berta00/precharge-controller/README.md

# Hardware precharge-controller
Hardware-only precharge controller design for the E-Agle Trento Racing Team electronics recruitment test.
[Project task](https://github.com/eagletrt/recruitment-hw/tree/master/task-3)

## Project structure
- `./docs`:
  - `datasheet`: Datasheets of all the used components
  - `img`: Images used in markdown files
  - `BOM.csv`: Bill Of Material file
  - `DESCRIPTION.md`: Description file containing a complete overview about the project
  - `SIZING.md`: Sizing file containing all the calculations and considerations
  - `precharge-controller.pdf`: Final project sheets export
- `./hardware`:
  - `libs`: Libraries used in kicad project
  - `sim`: LTspice simulation files
  - `kicad files`

## Project description
For for a project description, refer to the [Project Description](docs/DESCRIPTION.md) \
For the sizing calculations, refer to the [Project Sizings](docs/SIZING.md)
