berta00/precharge-controller/docs/img/lv_logic_2_sheet.png

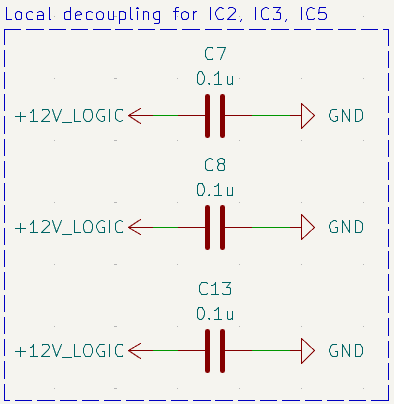
docs/img/lv_logic_2_sheet.png
