berta00/precharge-controller/docs/img/TC4S584F_VP_PLOT.png

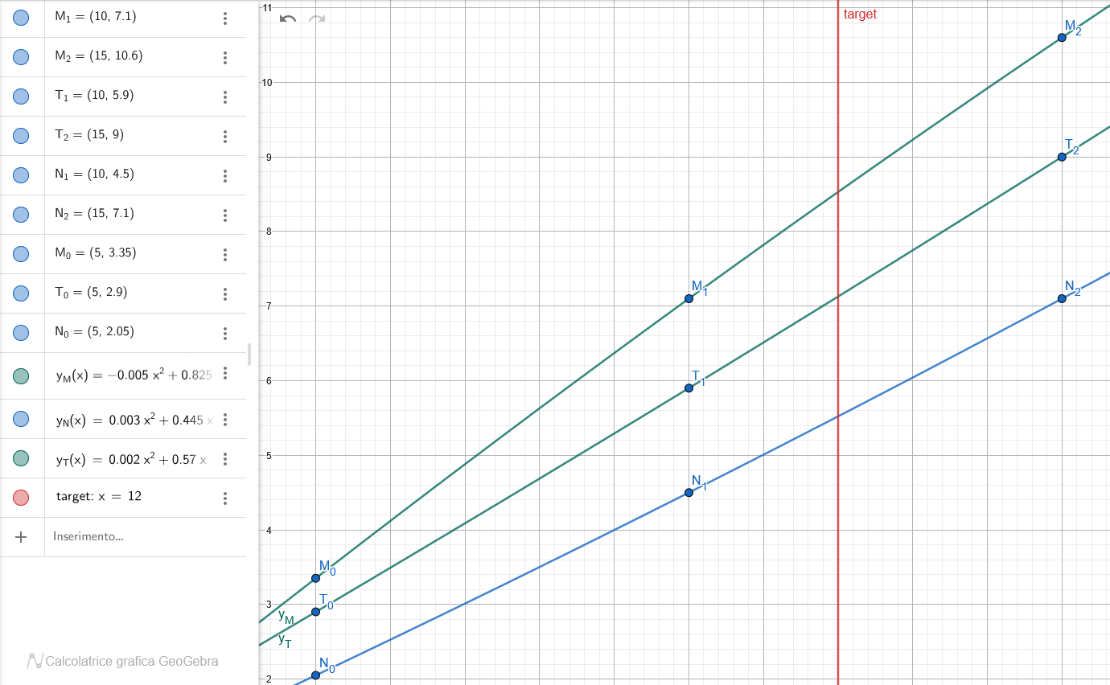
docs/img/TC4S584F_VP_PLOT.png
