berta00/precharge-controller/docs/BOM.csv

Reference | Qty | Value | Manufacturer_Part_Number | Mouser Part Number | MANUFACTURER | Datasheet
C1 | 1 | 0.33uF | C0805C334J5RACAUTO | 80-C0805C334J5RAUTO | KEMET | link
C2,C3,C7,C8,C10,C11,C12,C13 | 8 | 0.1uF | C0805X104K5RACAUTO | 80-C0805X104K5RAUTO | KEMET | link
C4 | 1 | 270uF | 35CZH270M10X9 | 232-35CZH270M10X9 | Rubycon | link
C5,C6,C9 | 3 | 1uF | C0805X105J5RACAUTO | 80-C0805X105J5RAUTO | KEMET | link
C14,C15,C16 | 3 | 3600uF | PHH223HKP4360ME4 | 80-PHH223HKP4360ME4 | KEMET | link
D1,D3 | 2 | 15V | MMSZ5245BHE3-TP | 833-MMSZ5245BHE3-TP | Micro Commercial Components (MCC) | link
D2,D13 | 2 | 28V | MMSZ5255BQ-7-F | 621-MMSZ5255BQ-7-F | Diodes Incorporated | link
D5,D12 | 2 | 12V | BZT52C12-HE3-08 | 78-BZT52C12-HE3-08 | Vishay Semiconductors | link
D6,D8,D10 | 3 | 400V | S1G | 603-S1G | YAGEO | link
D7,D9,D11 | 3 | 36V | 1SMA5938BT3G | 863-1SMA5938BT3G | onsemi | link
IC1 | 1 | L7812ABV | L7812ABV | 511-L7812ABV | STMicroelectronics | link
IC2 | 1 | CD4081BM96 | CD4081BM96 | 595-CD4081BM96 | Texas Instruments | link
IC3 | 1 | CD40106BM96 | CD40106BM96 | 595-CD40106BM96 | Texas Instruments | link
IC4 | 1 | LM393BIDR | LM393BIDR | 595-LM393BIDR | Texas Instruments | link
IC5 | 1 | CD4071BM96 | CD4071BM96 | 595-CD4071BM96 | Texas Instruments | link
J1 | 1 | DTF13-4P-G003 | DTF13-4P-G003 | 571-DTF13-4P-G003 | TE Connectivity / DEUTSCH | link
J2,J3,J4 | 3 | 9500630000 | 9500630000 | 470-9500630000 | Weidmuller | link
PS1 | 1 | DEP1-12-S12-M | DEP1-12-S12-M | 490-DEP1-12-S12-M | CUI Inc. | link
Q1,Q2 | 2 | SI3437DV-T1-GE3 | SI3437DV-T1-GE3 | 781-SI3437DV-GE3 | Vishay Semiconductors | link
Q3,Q5,Q6 | 3 | DMN6140LQ-7 | DMN6140LQ-7 | 621-DMN6140LQ-7 | Diodes Incorporated | link
Q4 | 1 | 2N7002K | 2N7002K | 512-2N7002K | onsemi | link
Q7 | 1 | APC-817D1-SL | APC-817D1-SL | 442-APC817D1SL | American Bright LED | link
R1,R2,R8,R10,R11,R12,R13,R24 | 8 | 10k | AT0805FRD0710KL | 603-AT0805FRD0710KL | YAGEO | link
R3,R4,R5,R20,R21,R22 | 6 | 330k | TNPV1206330KBEEA | 71-TNPV1206330KBEEA | Vishay / Dale | link
R6 | 1 | 56k | ERA-6ARB563V | 667-ERA-6ARB563V | Panasonic Industry | link
R7 | 1 | 20k | ERA-8APB203V | 667-ERA-8APB203V | Panasonic Industry | link
R9 | 1 | 4.7k | AA0805FR-074K7L | 603-AA0805FR-074K7L | YAGEO | link
R14,R15,R16,R18 | 4 | 1k | RC0805FR-071KL | 603-RC0805FR-071KL | YAGEO | link
R19 | 1 | 100 | AA0805FR-13100RL | 603-AA0805FR-13100RL | YAGEO | link
R23 | 1 | 21k | ERA-8AEB2102V | 667-ERA-8AEB2102V | Panasonic Industry | link
R25,R26,R27 | 3 | 51 | RSF2WSJR-52-51R | 603-RSF2WSJR-52-51R | YAGEO | link
R28,R29 | 2 | 10 | SR0805FR-7W10RL | 603-SR0805FR-7W10RL | YAGEO | link
U2,U3,U4 | 3 | G9KB-1A DC12 | G9KB-1ADC12 | 653-G9KB-1ADC12 | Aratas | link
Precharge resistor | 1 | / | HSA501K0J | 279-HSA501K0J | TE Connectivity / Holsworthy | link
Male lv connector | 1 | / | DT06-4S | 571-DT06-4S | TE Connectivity / DEUTSCH | link
Wedge lv connector | 1 | / | W4S-ZZ | 571-W4S-ZZ | TE Connectivity / DEUTSCH | link
Internal pins lv connector | 4 | / | 0462-201-1631 | 571-0462-201-1631 | TE Connectivity / DEUTSCH | link
