berta00/precharge-controller/docs/precharge-controller.pdf

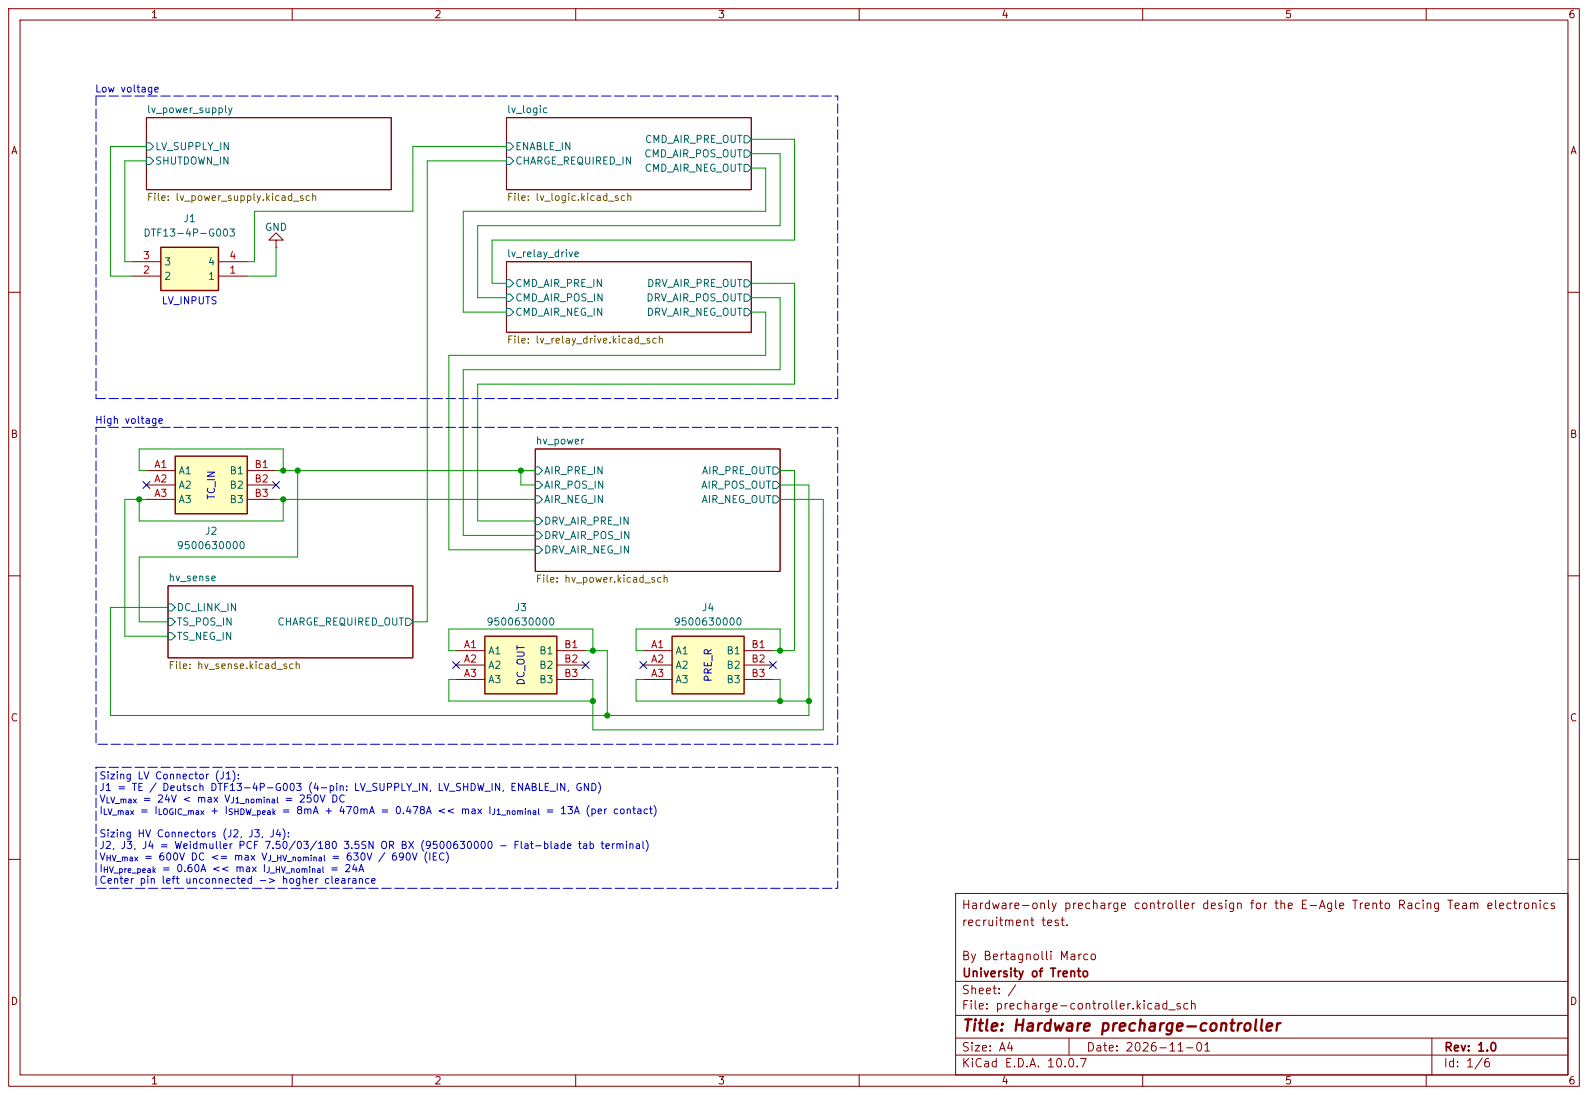
[picture p20: page 1]

Sizing LV Connector (J1): J1 = TE / Deutsch DTF13-4P-G003 (4-pin: LV_SUPPLY_IN, LV_SHDW_IN, ENABLE_IN, GND) VLV_max = 24V < max VJ1_nominal = 250V DC

Sizing HV Connectors (J2, J3, J4):
J2, J3, J4 = Weidmuller PCF 7.50/03/180 3.5SN OR BX (9500630000 - Flat-blade tab terminal) VHV_max = 600V DC <= max VJ_HV_nominal = 630V / 690V (IEC)

IHV_pre_peak = 0.60A << max IJ_HV_nominal = 24A Center pin left unconnected -> hogher clearance

Hardware-only precharge controller design for the E-Agle Trento Racing Team electronics
recruitment test.

By Bertagnolli Marco
University of Trento
Sheet: /
File: precharge-controller.kicad_sch
Title: Hardware precharge-controller

Size: A4 | Rev: 1.0
KiCad E.D.A. 10.0.7 | Id: 1/6

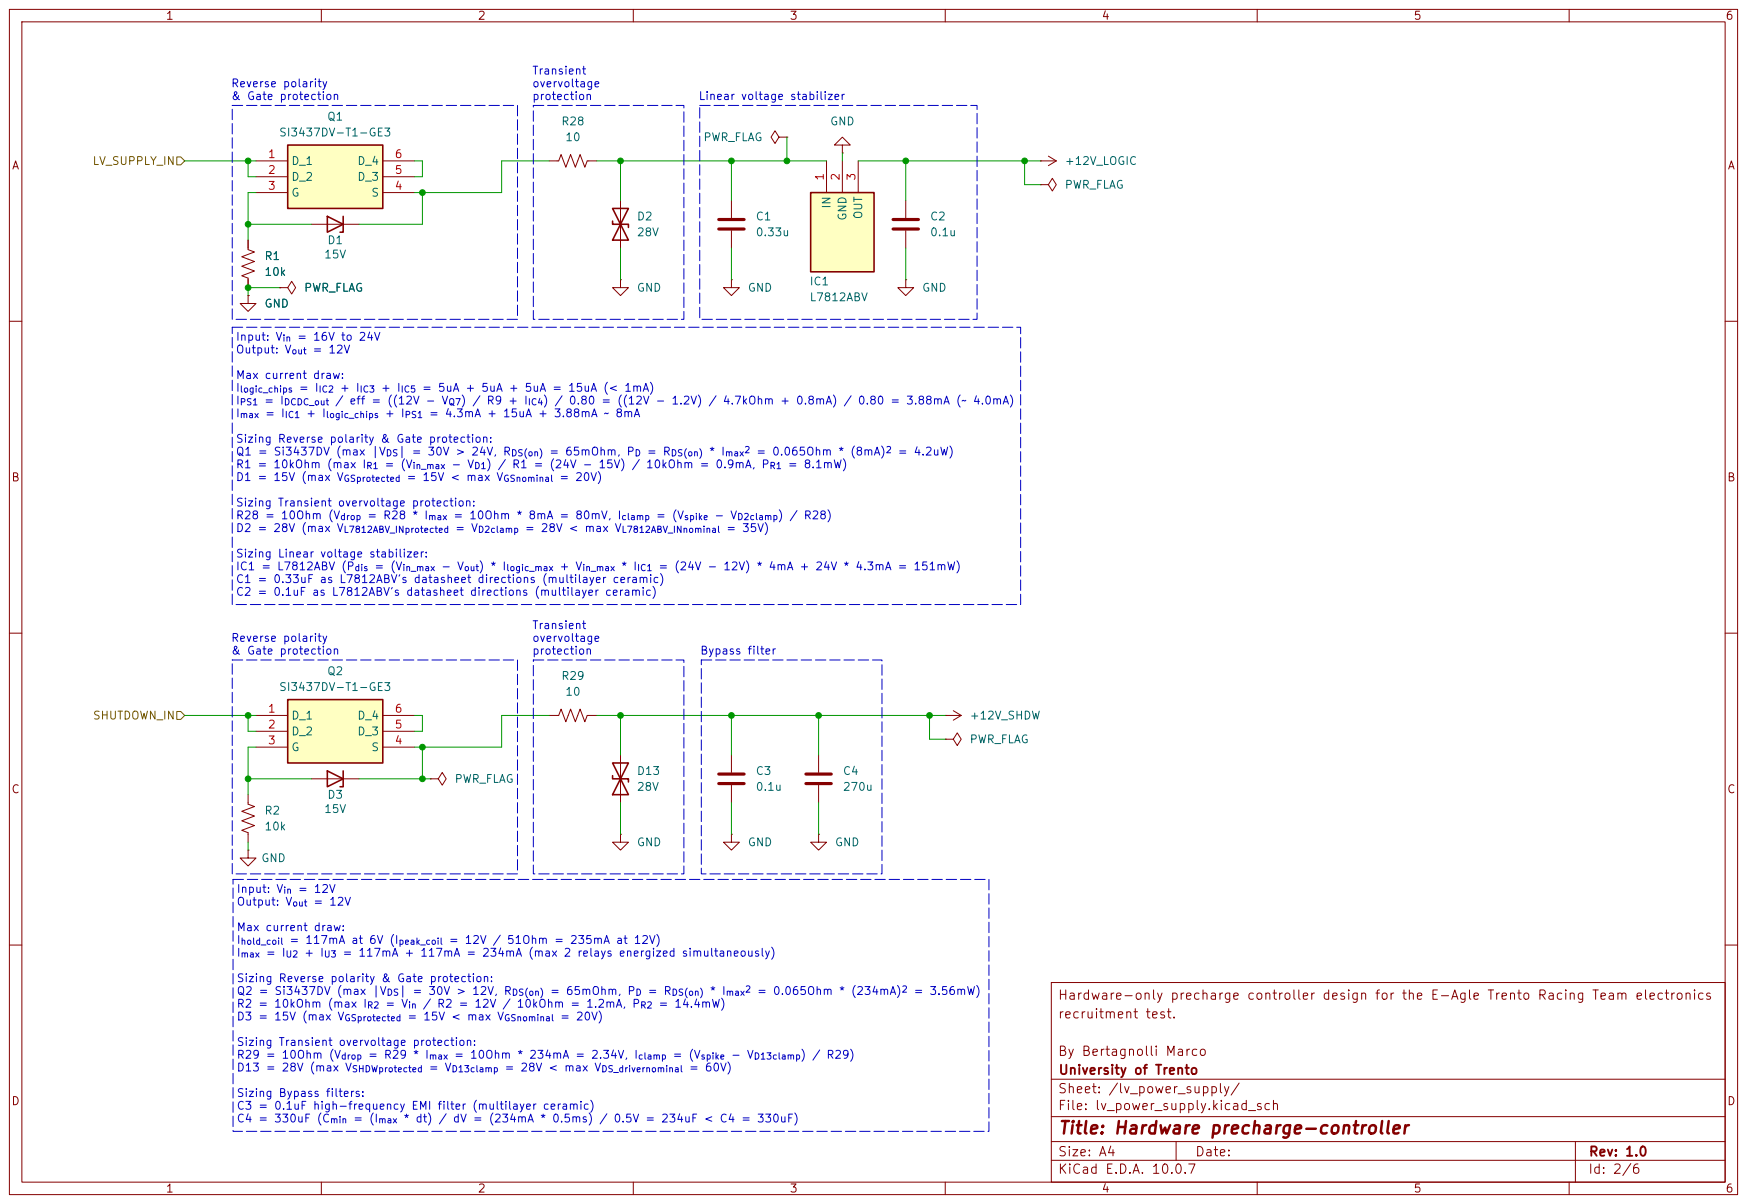
[picture p21: page 2]

Input: Vin = 16V to 24V Output: Vout = 12V Max current draw:

Ilogic_chips = IIC2 + IIC3 + IIC5 = 5uA + 5uA + 5uA = 15uA (< 1mA)
IPS1 = IDCDC_out / eff = ((12V - VQ7) / R9 + IIC4) / 0.80 = ((12V - 1.2V) / 4.7kOhm + 0.8mA) / 0.80 = 3.88mA (~ 4.0mA)
Imax = IIC1 + Ilogic_chips + IPS1 = 4.3mA + 15uA + 3.88mA ~ 8mA Sizing Reverse polarity & Gate protection: Q1 = Si3437DV (max |VDS| = 30V > 24V, RDS(on) = 65mOhm, PD = RDS(on) * Imax2 = 0.065Ohm * (8mA)2 = 4.2uW) R1 = 10kOhm (max IR1 = (Vin_max - VD1) / R1 = (24V - 15V) / 10kOhm = 0.9mA, PR1 = 8.1mW) D1 = 15V (max VGSprotected = 15V < max VGSnominal = 20V)

Sizing Transient overvoltage protection: R28 = 10Ohm (Vdrop = R28 * Imax = 10Ohm * 8mA = 80mV, Iclamp = (Vspike - VD2clamp) / R28) D2 = 28V (max VL7812ABV_INprotected = VD2clamp = 28V < max VL7812ABV_INnominal = 35V)

Sizing Linear voltage stabilizer:
IC1 = L7812ABV (Pdis = (Vin_max - Vout) * Ilogic_max + Vin_max * IIC1 = (24V - 12V) * 4mA + 24V * 4.3mA = 151mW) C1 = 0.33uF as L7812ABV's datasheet directions (multilayer ceramic) C2 = 0.1uF as L7812ABV's datasheet directions (multilayer ceramic)

Bypass filter Reverse polarity & Gate protection

Input: Vin = 12V Output: Vout = 12V Max current draw:

Ihold_coil = 117mA at 6V (Ipeak_coil = 12V / 51Ohm = 235mA at 12V)
Imax = IU2 + IU3 = 117mA + 117mA = 234mA (max 2 relays energized simultaneously)

Sizing Reverse polarity & Gate protection: Q2 = Si3437DV (max |VDS| = 30V > 12V, RDS(on) = 65mOhm, PD = RDS(on) * Imax2 = 0.065Ohm * (234mA)2 = 3.56mW) R2 = 10kOhm (max IR2 = Vin / R2 = 12V / 10kOhm = 1.2mA, PR2 = 14.4mW) D3 = 15V (max VGSprotected = 15V < max VGSnominal = 20V)

Hardware-only precharge controller design for the E-Agle Trento Racing Team electronics
recruitment test.

Sizing Transient overvoltage protection: R29 = 10Ohm (Vdrop = R29 * Imax = 10Ohm * 234mA = 2.34V, Iclamp = (Vspike - VD13clamp) / R29) D13 = 28V (max VSHDWprotected = VD13clamp = 28V < max VDS_drivernominal = 60V)

By Bertagnolli Marco
University of Trento
Sheet: /lv_power_supply/
File: lv_power_supply.kicad_sch
Title: Hardware precharge-controller

Sizing Bypass filters: C3 = 0.1uF high-frequency EMI filter (multilayer ceramic) C4 = 330uF (Cmin = (Imax * dt) / dV = (234mA * 0.5ms) / 0.5V = 234uF < C4 = 330uF)

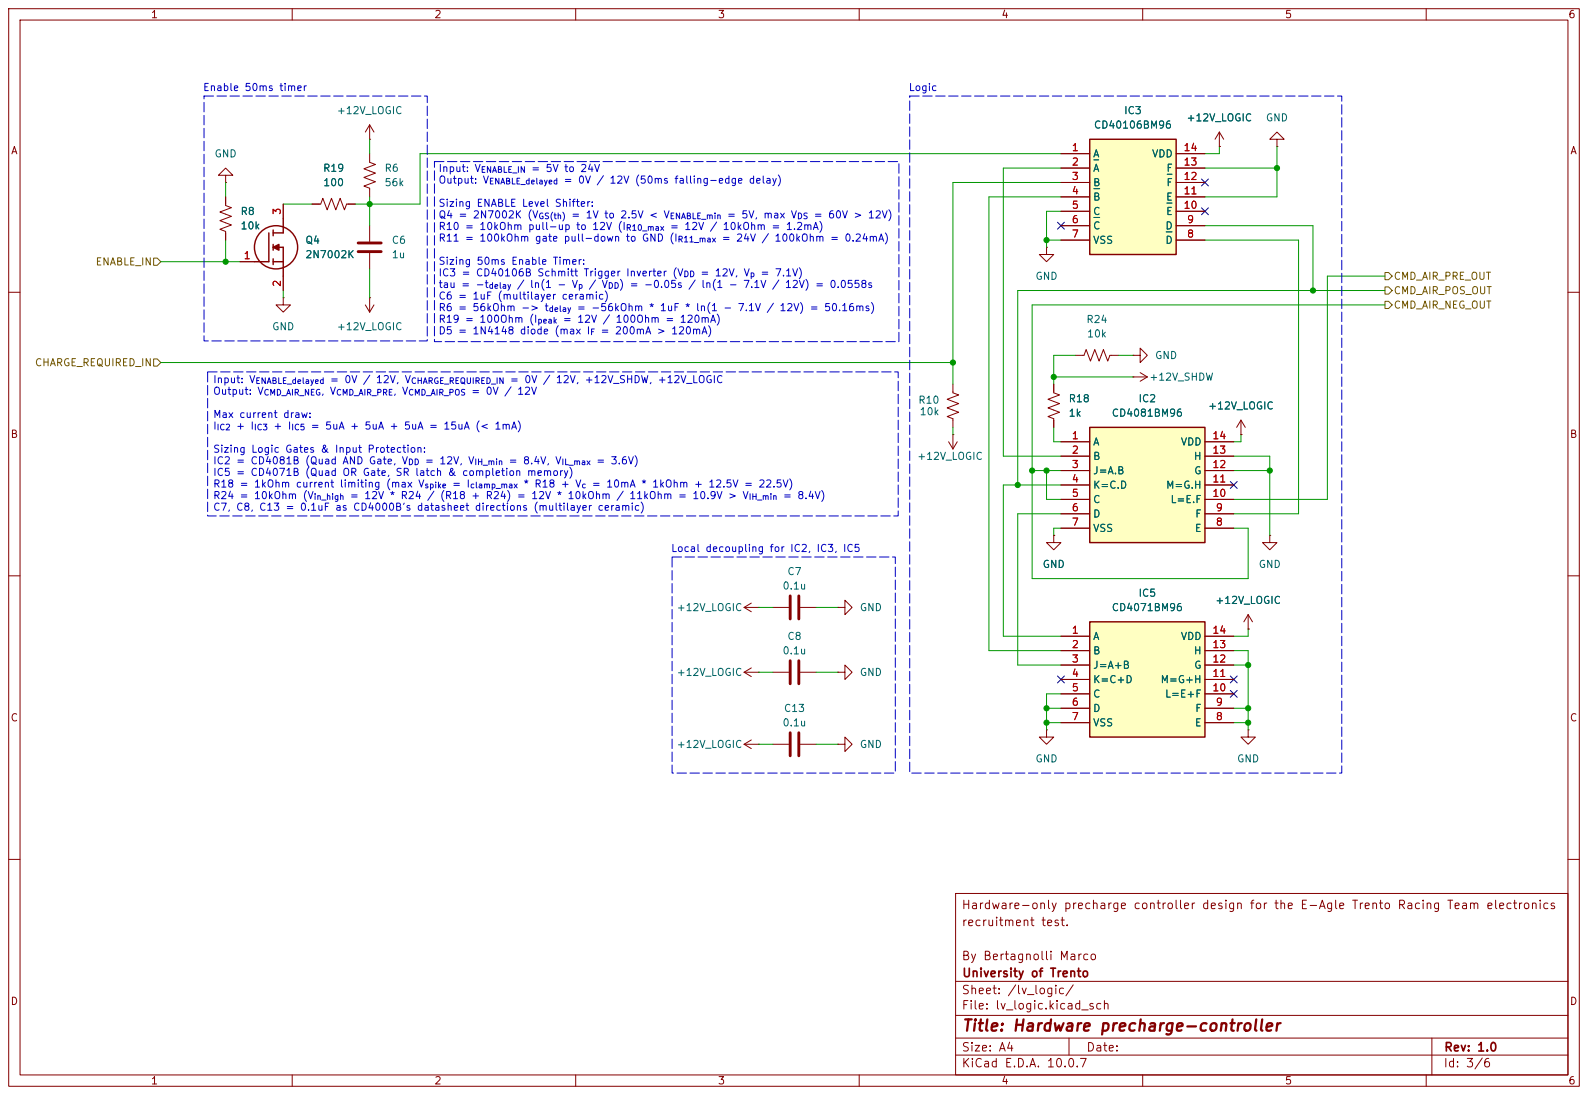
[picture p22: page 3]

Input: VENABLE_IN = 5V to 24V Output: VENABLE_delayed = 0V / 12V (50ms falling-edge delay)

Sizing ENABLE Level Shifter: Q4 = 2N7002K (VGS(th) = 1V to 2.5V < VENABLE_min = 5V, max VDS = 60V > 12V) R10 = 10kOhm pull-up to 12V (IR10_max = 12V / 10kOhm = 1.2mA) R11 = 100kOhm gate pull-down to GND (IR11_max = 24V / 100kOhm = 0.24mA)

Sizing 50ms Enable Timer:
IC3 = CD40106B Schmitt Trigger Inverter (VDD = 12V, Vp = 7.1V)
tau = -tdelay / ln(1 - Vp / VDD) = -0.05s / ln(1 - 7.1V / 12V) = 0.0558s C6 = 1uF (multilayer ceramic) R6 = 56kOhm -> tdelay = -56kOhm * 1uF * ln(1 - 7.1V / 12V) = 50.16ms) R19 = 100Ohm (Ipeak = 12V / 100Ohm = 120mA) D5 = 1N4148 diode (max IF = 200mA > 120mA)

Input: VENABLE_delayed = 0V / 12V, VCHARGE_REQUIRED_IN = 0V / 12V, +12V_SHDW, +12V_LOGIC Output: VCMD_AIR_NEG, VCMD_AIR_PRE, VCMD_AIR_POS = 0V / 12V Max current draw:

Sizing Logic Gates & Input Protection:
IC2 = CD4081B (Quad AND Gate, VDD = 12V, VIH_min = 8.4V, VIL_max = 3.6V)
IC5 = CD4071B (Quad OR Gate, SR latch & completion memory) R18 = 1kOhm current limiting (max Vspike = Iclamp_max * R18 + Vc = 10mA * 1kOhm + 12.5V = 22.5V) R24 = 10kOhm (Vin_high = 12V * R24 / (R18 + R24) = 12V * 10kOhm / 11kOhm = 10.9V > VIH_min = 8.4V)

C7, C8, C13 = 0.1uF as CD4000B's datasheet directions (multilayer ceramic)

Hardware-only precharge controller design for the E-Agle Trento Racing Team electronics C7

By Bertagnolli Marco
University of Trento
Sheet: /lv_logic/
File: lv_logic.kicad_sch
Title: Hardware precharge-controller

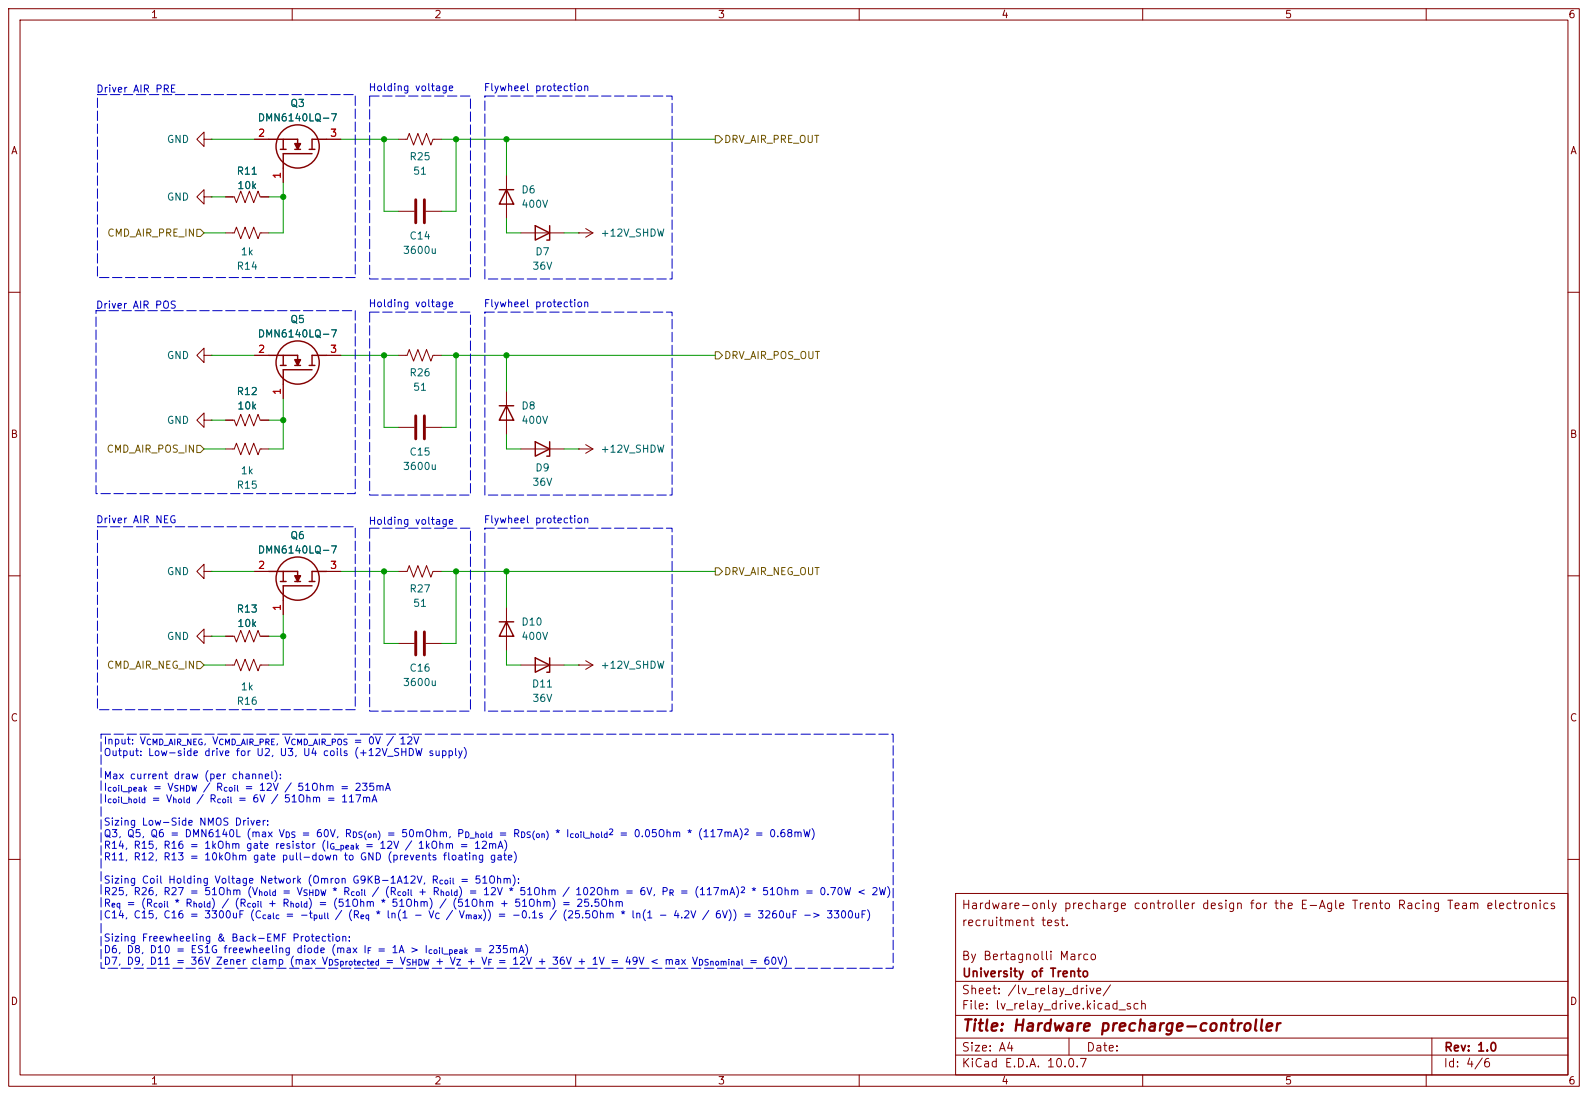
[picture p23: page 4]

Hardware-only precharge controller design for the E-Agle Trento Racing Team electronics D9

Input: VCMD_AIR_NEG, VCMD_AIR_PRE, VCMD_AIR_POS = 0V / 12V Output: Low-side drive for U2, U3, U4 coils (+12V_SHDW supply) Max current draw (per channel):

Icoil_peak = VSHDW / Rcoil = 12V / 51Ohm = 235mA
Icoil_hold = Vhold / Rcoil = 6V / 51Ohm = 117mA Sizing Low-Side NMOS Driver: Q3, Q5, Q6 = DMN6140L (max VDS = 60V, RDS(on) = 50mOhm, PD_hold = RDS(on) * Icoil_hold2 = 0.05Ohm * (117mA)2 = 0.68mW)

R14, R15, R16 = 1kOhm gate resistor (IG_peak = 12V / 1kOhm = 12mA)
R11, R12, R13 = 10kOhm gate pull-down to GND (prevents floating gate)

Sizing Coil Holding Voltage Network (Omron G9KB-1A12V, Rcoil = 51Ohm):
R25, R26, R27 = 51Ohm (Vhold = VSHDW * Rcoil / (Rcoil + Rhold) = 12V * 51Ohm / 102Ohm = 6V, PR = (117mA)2 * 51Ohm = 0.70W < 2W) Req = (Rcoil * Rhold) / (Rcoil + Rhold) = (51Ohm * 51Ohm) / (51Ohm + 51Ohm) = 25.5Ohm

C14, C15, C16 = 3300uF (Ccalc = -tpull / (Req * ln(1 - VC / Vmax)) = -0.1s / (25.5Ohm * ln(1 - 4.2V / 6V)) = 3260uF -> 3300uF)

Sizing Freewheeling & Back-EMF Protection: D6, D8, D10 = ES1G freewheeling diode (max IF = 1A > Icoil_peak = 235mA)

By Bertagnolli Marco
University of Trento
Sheet: /lv_relay_drive/
File: lv_relay_drive.kicad_sch
Title: Hardware precharge-controller

D7, D9, D11 = 36V Zener clamp (max VDSprotected = VSHDW + VZ + VF = 12V + 36V + 1V = 49V < max VDSnominal = 60V)

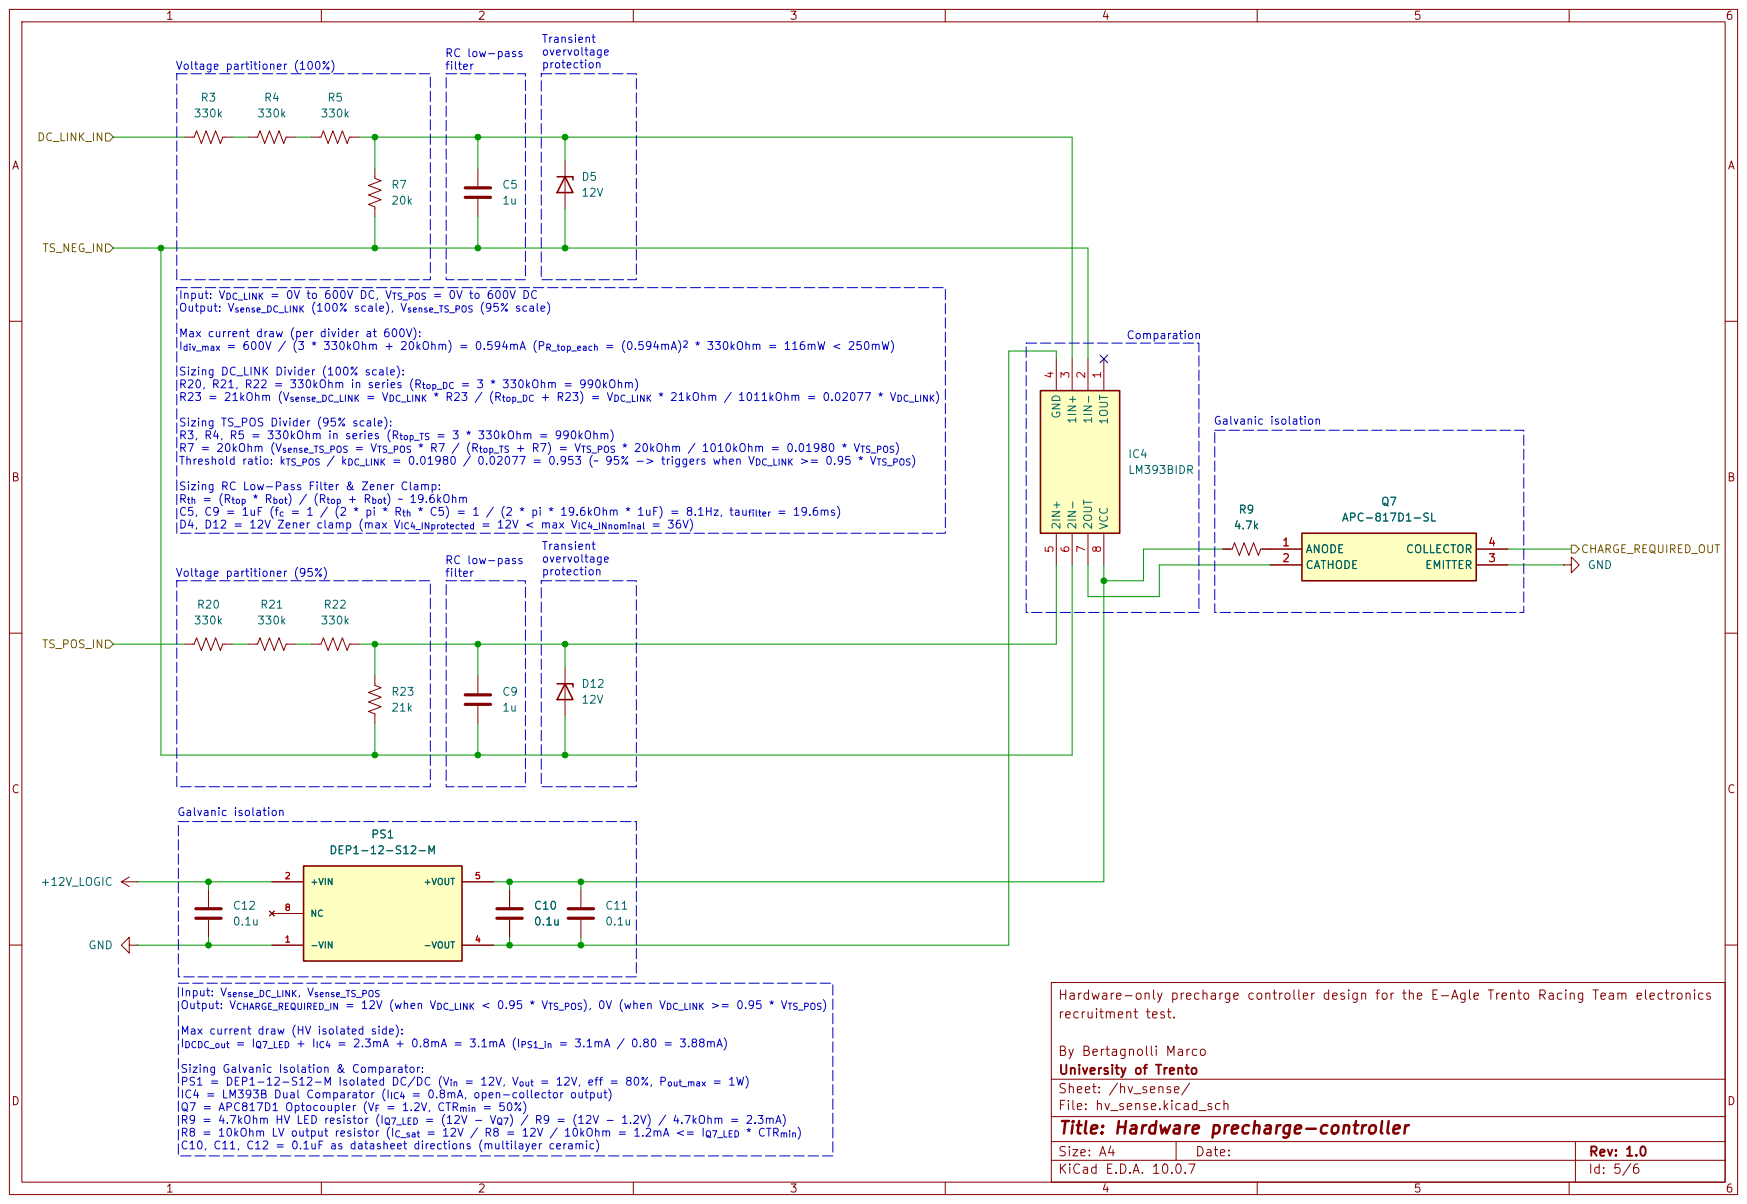
[picture p24: page 5]

Input: VDC_LINK = 0V to 600V DC, VTS_POS = 0V to 600V DC Output: Vsense_DC_LINK (100% scale), Vsense_TS_POS (95% scale) Max current draw (per divider at 600V):

Sizing TS_POS Divider (95% scale):
R3, R4, R5 = 330kOhm in series (Rtop_TS = 3 * 330kOhm = 990kOhm) R7 = 20kOhm (Vsense_TS_POS = VTS_POS * R7 / (Rtop_TS + R7) = VTS_POS * 20kOhm / 1010kOhm = 0.01980 * VTS_POS) Threshold ratio: kTS_POS / kDC_LINK = 0.01980 / 0.02077 = 0.953 (~ 95% -> triggers when VDC_LINK >= 0.95 * VTS_POS)

Sizing RC Low-Pass Filter & Zener Clamp: Rth = (Rtop * Rbot) / (Rtop + Rbot) ~ 19.6kOhm

C5, C9 = 1uF (fc = 1 / (2 * pi * Rth * C5) = 1 / (2 * pi * 19.6kOhm * 1uF) = 8.1Hz, taufilter = 19.6ms)
D4, D12 = 12V Zener clamp (max VIC4_INprotected = 12V < max VIC4_INnominal = 36V)

Input: Vsense_DC_LINK, Vsense_TS_POS Output: VCHARGE_REQUIRED_IN = 12V (when VDC_LINK < 0.95 * VTS_POS), 0V (when VDC_LINK >= 0.95 * VTS_POS) Max current draw (HV isolated side):

By Bertagnolli Marco
University of Trento
Sheet: /hv_sense/
File: hv_sense.kicad_sch
Title: Hardware precharge-controller

Sizing Galvanic Isolation & Comparator: PS1 = DEP1-12-S12-M Isolated DC/DC (Vin = 12V, Vout = 12V, eff = 80%, Pout_max = 1W)

IC4 = LM393B Dual Comparator (IIC4 = 0.8mA, open-collector output) Q7 = APC817D1 Optocoupler (VF = 1.2V, CTRmin = 50%) R9 = 4.7kOhm HV LED resistor (IQ7_LED = (12V - VQ7) / R9 = (12V - 1.2V) / 4.7kOhm = 2.3mA) R8 = 10kOhm LV output resistor (IC_sat = 12V / R8 = 12V / 10kOhm = 1.2mA <= IQ7_LED * CTRmin)

C10, C11, C12 = 0.1uF as datasheet directions (multilayer ceramic)

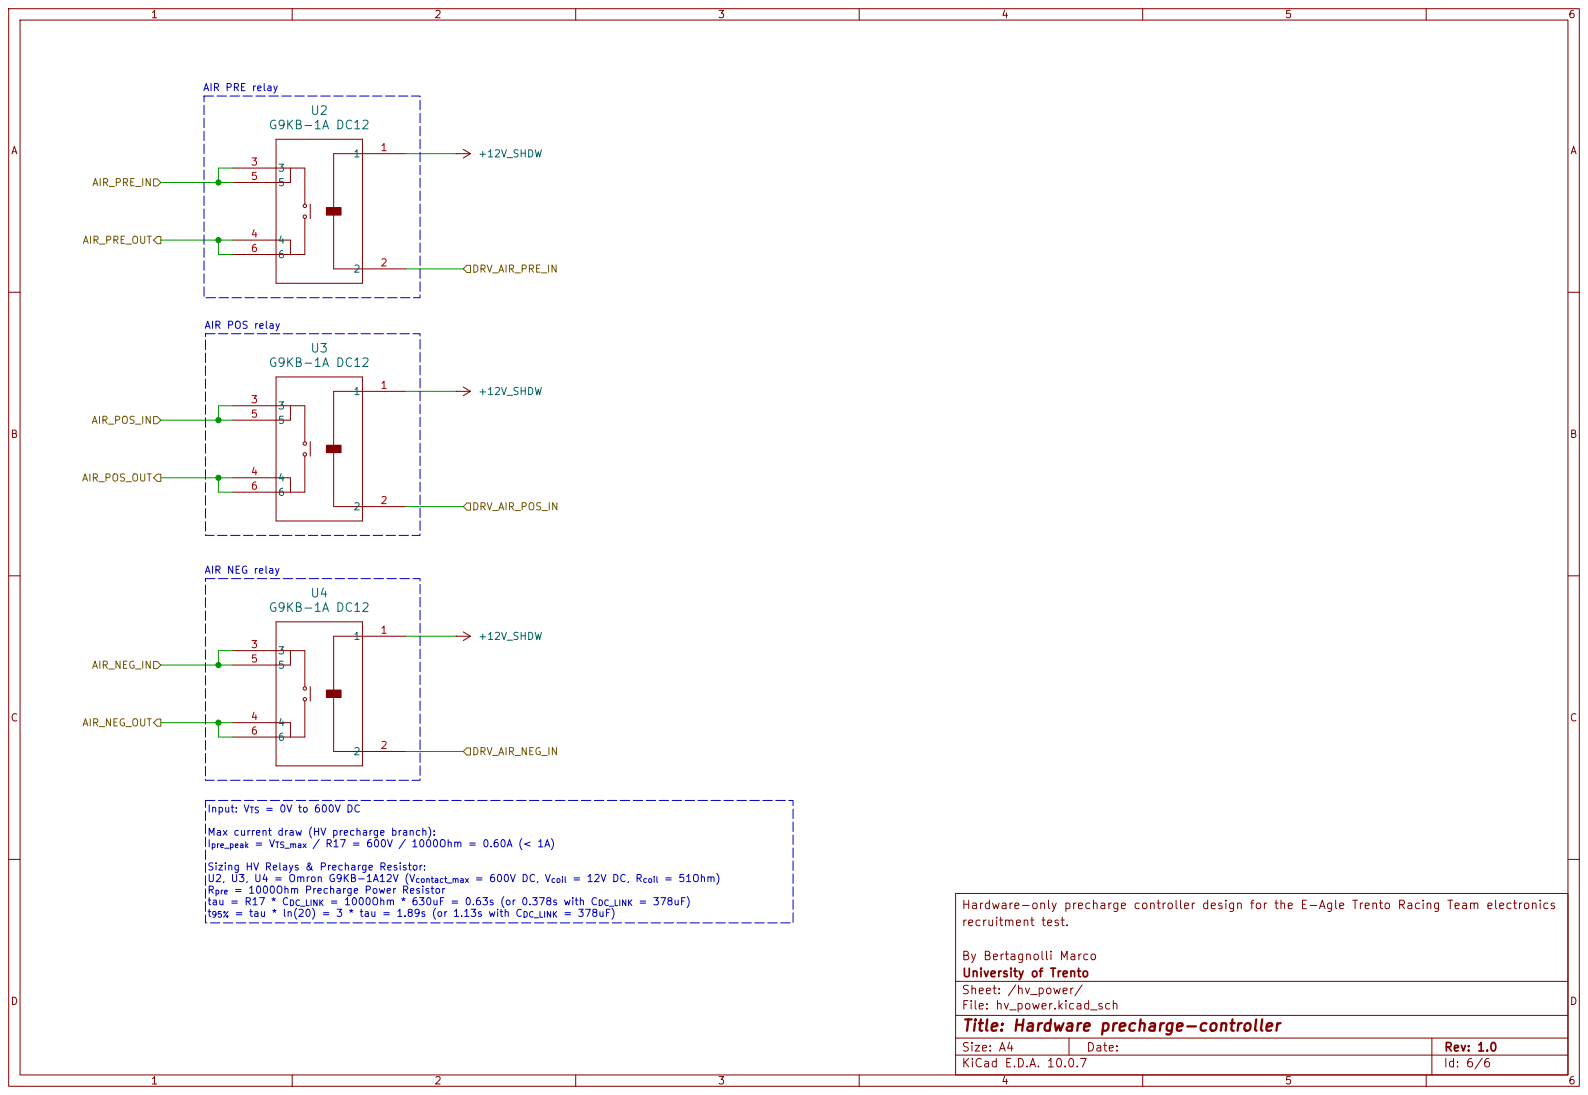
[picture p25: page 6]

Hardware-only precharge controller design for the E-Agle Trento Racing Team electronics +12V_SHDW

Input: VTS = 0V to 600V DC Max current draw (HV precharge branch):

Sizing HV Relays & Precharge Resistor: U2, U3, U4 = Omron G9KB-1A12V (Vcontact_max = 600V DC, Vcoil = 12V DC, Rcoil = 51Ohm) Rpre = 1000Ohm Precharge Power Resistor

tau = R17 * CDC_LINK = 1000Ohm * 630uF = 0.63s (or 0.378s with CDC_LINK = 378uF)
t95% = tau * ln(20) = 3 * tau = 1.89s (or 1.13s with CDC_LINK = 378uF)

By Bertagnolli Marco
University of Trento
Sheet: /hv_power/
File: hv_power.kicad_sch
Title: Hardware precharge-controller
