berta00/precharge-controller/hardware/sim/enabe_timer.asc

A1: inv; Vhigh=12 Vt=5.605 Vh=1.523
C1: cap; 1µ
M1: nmos; 2N7002
R1: res; 10k
R2: res; 55.5k
V1: voltage; 12
V2: voltage; PWL(0 0 199.999m 0 200m 12 299.999m 12 300m 0 329.999m 0 330m 12 399.999m 12 400m 0 599.999m 0 600m 12 639.99m 12 640m 0)
Named nets: 0
.tran 1s startup
Enable IN
