berta00/precharge-controller/hardware/sim/Draft3.asc

C1: cap; 1µ
R1: res; 55k
V1: voltage; 12
Named nets: 0
