berta00/precharge-controller/hardware/hi_sense.kicad_sch

## KiCad design hardware/hi_sense.kicad_sch (2026-10-21)

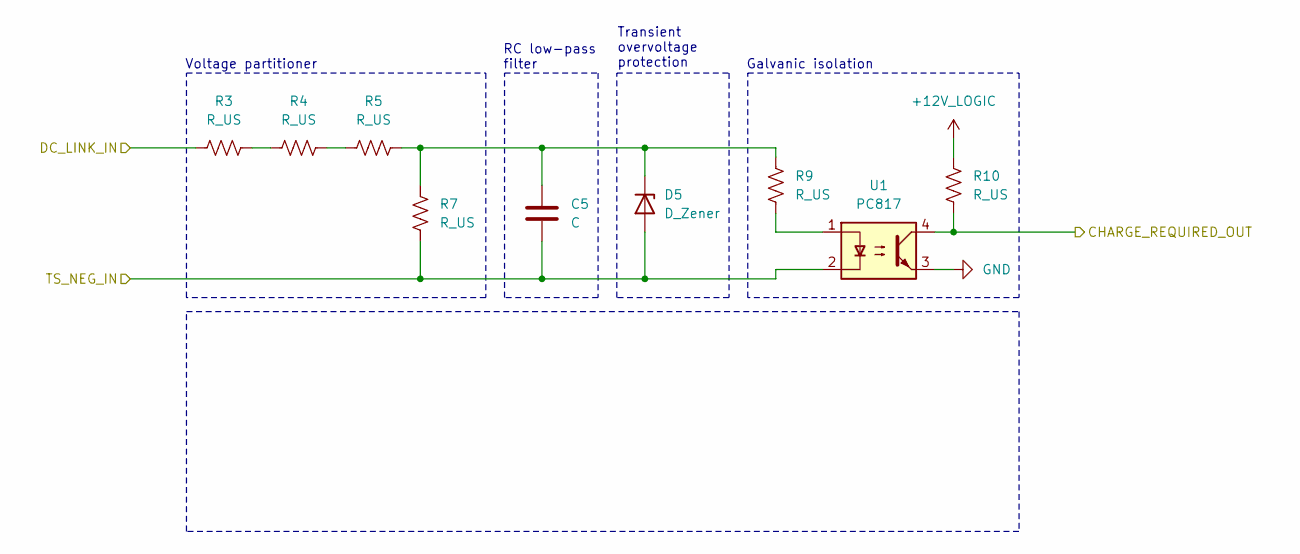
[picture p26: schematic hi_sense.kicad_sch]

Parts:
C5: C
D5: D_Zener
R3, R4, R5, R7, R9, R10: R_US
U1: PC817; DIP-4_W7.62mm

Connections:
+12V_LOGIC: R10.1
CHARGE_REQUIRED_OUT: R10.2, U1.4
DC_LINK_IN: R3.1
GND: U1.3
unnamed: C5.1, D5.1 (K), R5.2, R7.2, R9.1
unnamed: R3.2, R4.1
unnamed: R4.2, R5.1
unnamed: R9.2, U1.1
TS_NEG_IN: C5.2, D5.2 (A), R7.1, U1.2

Notes on the sheet:
Galvanic isolation
Transient overvoltage protection
Voltage partitioner
RC low-pass filter
