berta00/precharge-controller/hardware/hv_power.kicad_sch

## KiCad design hardware/hv_power.kicad_sch (2026-11-01)

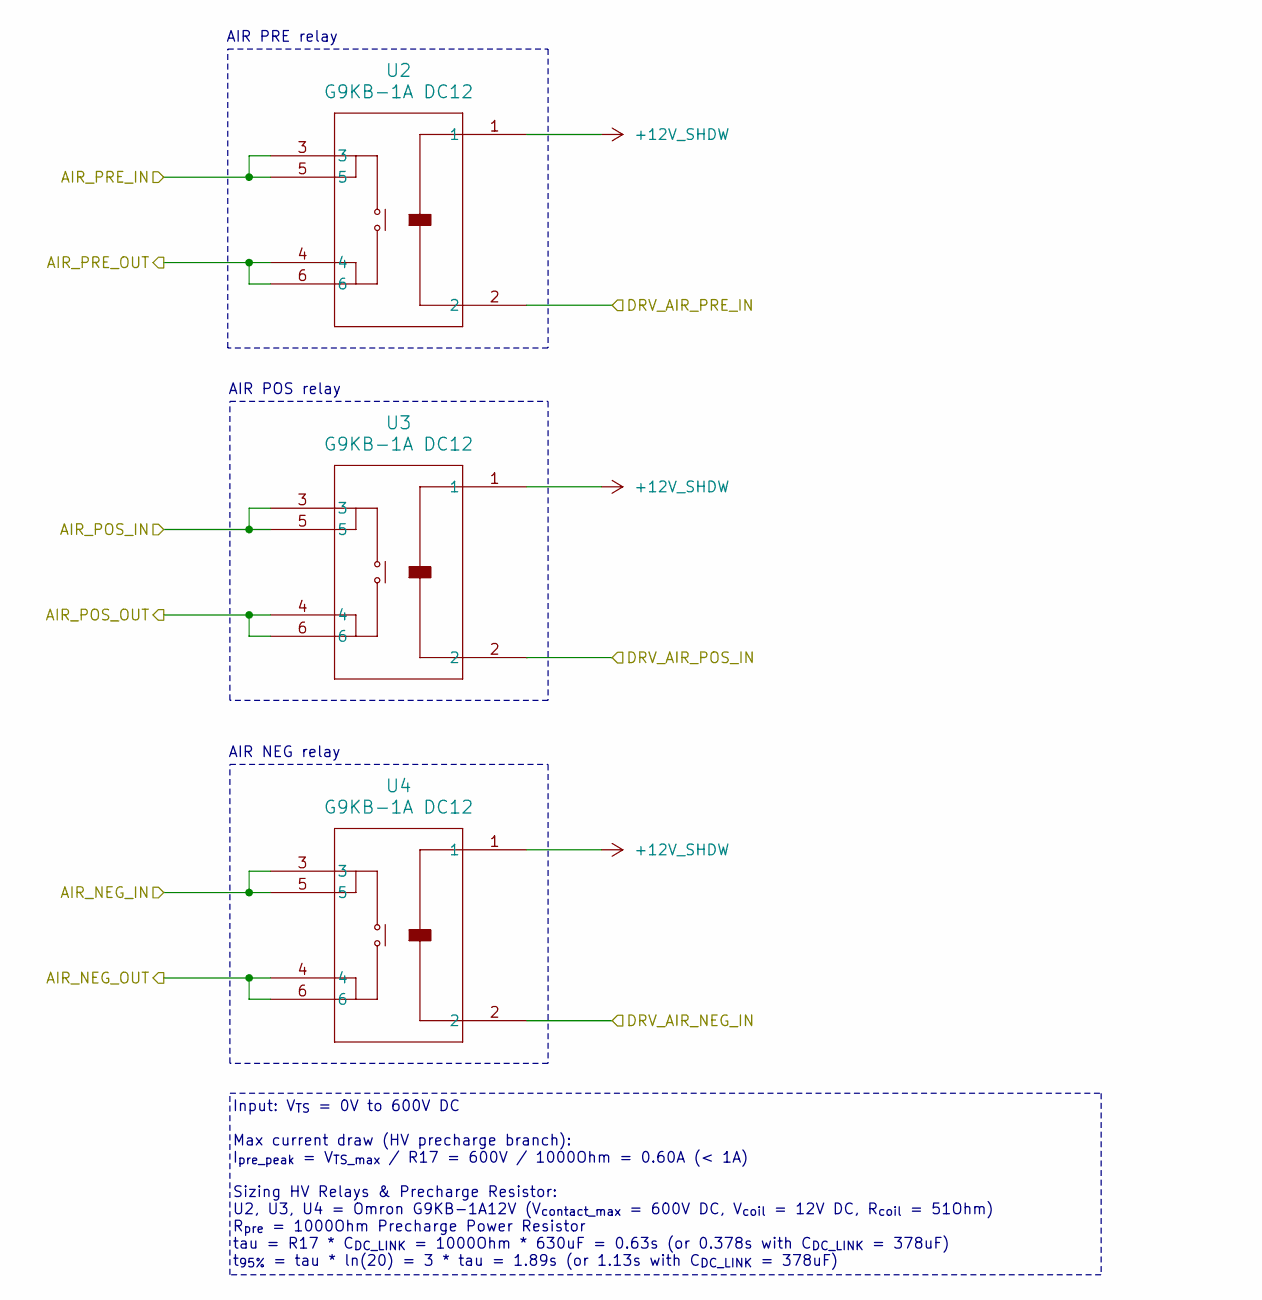
[picture p27: schematic hv_power.kicad_sch]

Parts:
U2, U3, U4: G9KB-1A DC12; G9KB_1A12V; Mouser Part Number 653-G9KB-1ADC12

Connections:
+12V_SHDW: U2.1, U3.1, U4.1
AIR_NEG_IN: U4.3, U4.5
AIR_NEG_OUT: U4.4, U4.6
AIR_POS_IN: U3.3, U3.5
AIR_POS_OUT: U3.4, U3.6
AIR_PRE_IN: U2.3, U2.5
AIR_PRE_OUT: U2.4, U2.6
DRV_AIR_NEG_IN: U4.2
DRV_AIR_POS_IN: U3.2
DRV_AIR_PRE_IN: U2.2

Notes on the sheet:
AIR PRE relay
Input: V_{TS} = 0V to 600V DC Max current draw (HV precharge branch): I_{pre_peak} = V_{TS_max} / R17 = 600V / 1000Ohm = 0.60A (< 1A) Sizing HV Relays & Precharge Resistor: U2, U3, U4 = Omron G9KB-1A12V (V_{contact_max} = 600V DC, V_{coil} = 12V DC, R_{coil} = 51Ohm) R_{pre} = 1000Ohm Precharge Pow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
AIR POS relay
AIR NEG relay
