berta00/precharge-controller/hardware/hv_sense.kicad_sch

## KiCad design hardware/hv_sense.kicad_sch (2026-11-01)

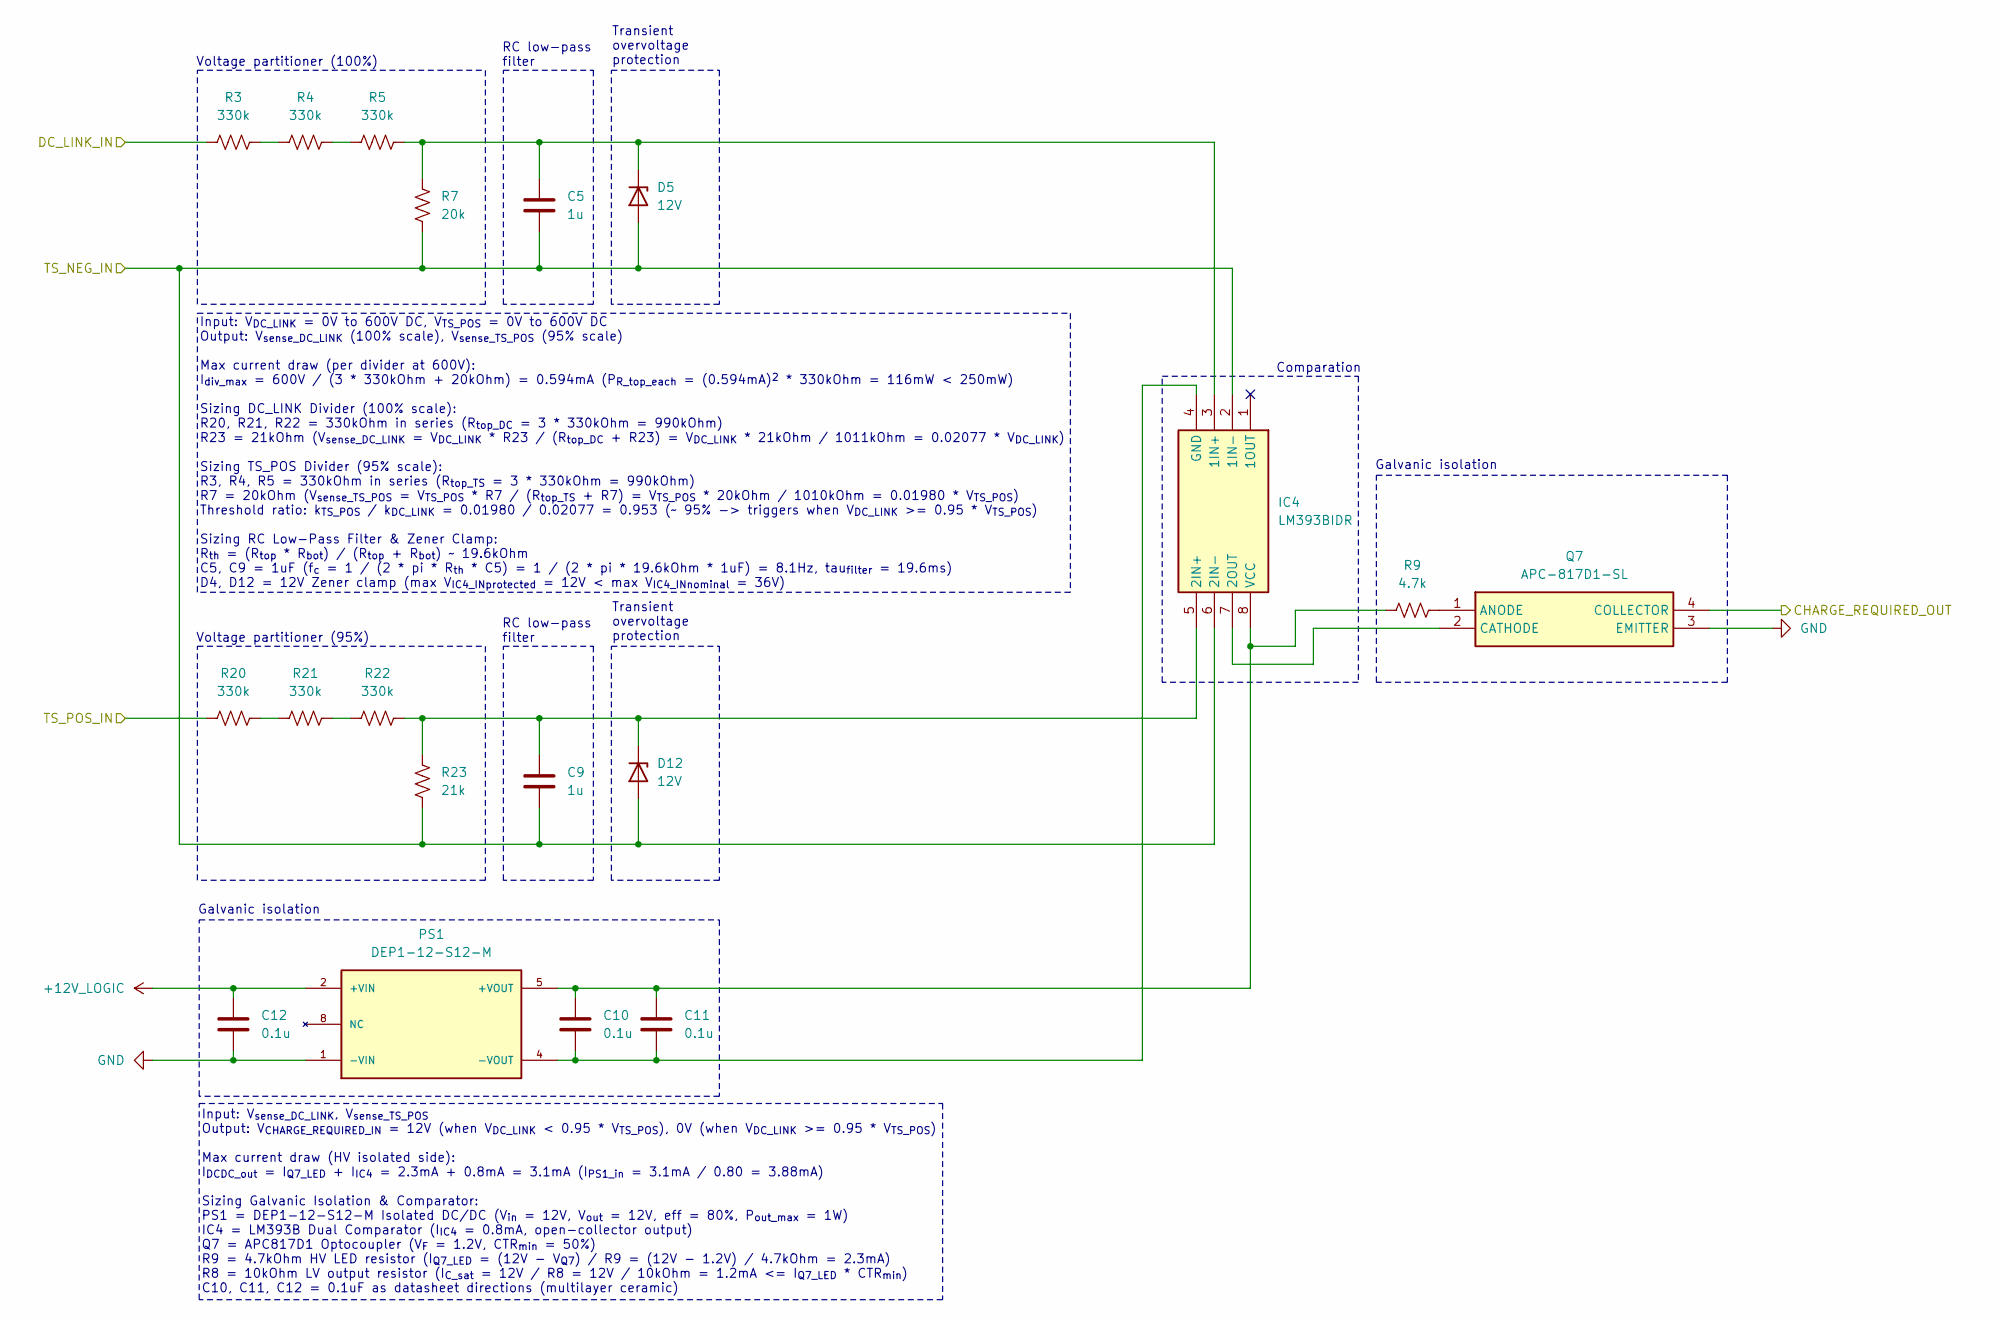
[picture p28: schematic hv_sense.kicad_sch]

Parts:
C5, C9: 1u; C0805; Manufacturer_Part_Number C0805X105J5RACAUTO; Mouser Part Number 80-C0805X105J5RAUTO
C10, C11, C12: 0.1u; C0805; Manufacturer_Part_Number C0805X104K5RACAUTO; Mouser Part Number 80-C0805X104K5RAUTO
D5, D12: 12V; SOD3716X145N; Manufacturer_Part_Number BZT52C12-HE3-08; Mouser Part Number 78-BZT52C12-HE3-08
IC4: LM393BIDR; SOIC127P600X175-8N; Manufacturer_Part_Number LM393BIDR; Mouser Part Number 595-LM393BIDR
PS1: DEP1-12-S12-M; PARTREV 1.0; Mouser Part Number 490-DEP1-12-S12-M
Q7: APC-817D1-SL; APC817D1SL; Manufacturer_Part_Number APC-817D1-SL; Mouser Part Number 442-APC817D1SL
R3, R4, R5, R20, R21, R22: 330k; Manufacturer_Part_Number TNPV1206330KBEEA; Mouser Part Number 71-TNPV1206330KBEEA
R7: 20k; Manufacturer_Part_Number ERA-8APB203V; Mouser Part Number 667-ERA-8APB203V
R9: 4.7k; Manufacturer_Part_Number AA0805FR-074K7L; Mouser Part Number 603-AA0805FR-074K7L
R23: 21k; Manufacturer_Part_Number ERA-8AEB2102V; Mouser Part Number 667-ERA-8AEB2102V

Connections:
+12V_LOGIC: C12.1, PS1.2 (+VIN)
CHARGE_REQUIRED_OUT: Q7.4 (COLLECTOR)
DC_LINK_IN: R3.1
GND: C12.2, PS1.1 (-VIN), Q7.3 (EMITTER)
unnamed: C5.1, D5.1 (K), IC4.3 (1IN+), R5.2, R7.2
unnamed: C9.1, D12.1 (K), IC4.5 (2IN+), R22.2, R23.2
unnamed: C10.1, C11.1, IC4.8 (VCC), PS1.5 (+VOUT), R9.1
unnamed: C10.2, C11.2, IC4.4 (GND), PS1.4 (-VOUT)
unnamed: IC4.7 (2OUT), Q7.2 (CATHODE)
unnamed: Q7.1 (ANODE), R9.2
unnamed: R3.2, R4.1
unnamed: R4.2, R5.1
unnamed: R20.2, R21.1
unnamed: R21.2, R22.1
TS_NEG_IN: C5.2, C9.2, D5.2 (A), D12.2 (A), IC4.2 (1IN-), IC4.6 (2IN-), R7.1, R23.1
TS_POS_IN: R20.1

Notes on the sheet:
Comparation
Transient overvoltage protection
RC low-pass filter
Input: V_{sense_DC_LINK}, V_{sense_TS_POS} Output: V_{CHARGE_REQUIRED_IN} = 12V (when V_{DC_LINK} < 0.95 * V_{TS_POS}), 0V (when V_{DC_LINK} >= 0.95 * V_{TS_POS}) Max current draw (HV isolated side): I_{DCDC_out} = I_{Q7_LED} + I_{IC4} = 2.3mA + 0.8mA = 3.1mA (I_{PS1_in} = 3.1mA / 0.80 = 3.88mA) Si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
Voltage partitioner (95%)
Galvanic isolation
Input: V_{DC_LINK} = 0V to 600V DC, V_{TS_POS} = 0V to 600V DC Output: V_{sense_DC_LINK} (100% scale), V_{sense_TS_POS} (95% scale) Max current draw (per divider at 600V): I_{div_max} = 600V / (3 * 330kOhm + 20kOhm) = 0.594mA (P_{R_top_each} = (0.594mA)^{2} * 330kOhm = 116mW < 250mW) Sizing DC_LINK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
Voltage partitioner (100%)
