berta00/precharge-controller/hardware/lv_logic.kicad_sch

## KiCad design hardware/lv_logic.kicad_sch (2026-11-01)

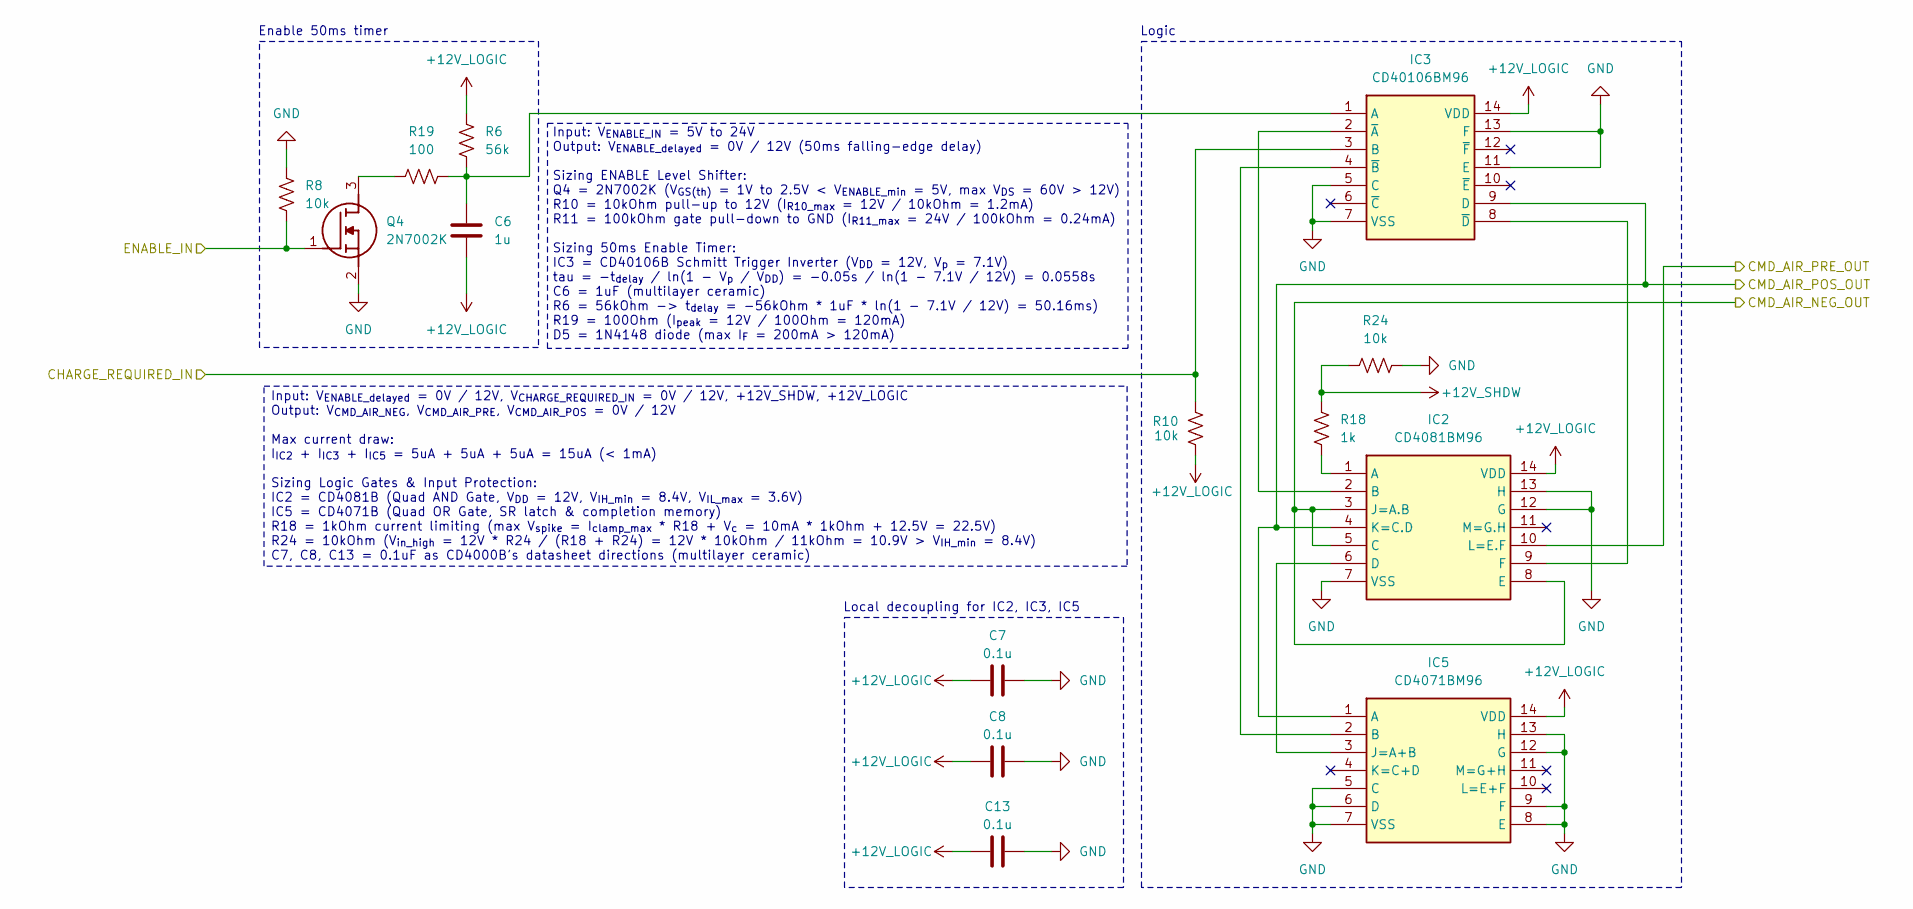
[picture p29: schematic lv_logic.kicad_sch]

Parts:
C6: 1u; C0805; Manufacturer_Part_Number C0805X105J5RACAUTO; Mouser Part Number 80-C0805X105J5RAUTO
C7, C8, C13: 0.1u; C0805; Manufacturer_Part_Number C0805X104K5RACAUTO; Mouser Part Number 80-C0805X104K5RAUTO
IC2: CD4081BM96; SOIC127P600X175-14N; Manufacturer_Part_Number CD4081BM96; Mouser Part Number 595-CD4081BM96
IC3: CD40106BM96; SOIC127P600X175-14N; Manufacturer_Part_Number CD40106BM96; Mouser Part Number 595-CD40106BM96
IC5: CD4071BM96; SOIC127P600X175-14N; Manufacturer_Part_Number CD4071BM96; Mouser Part Number 595-CD4071BM96
Q4: 2N7002K; SOT95P240X120-3N; Manufacturer_Part_Number 2N7002K; Mouser Part Number 512-2N7002K
R6: 56k; Manufacturer_Part_Number ERA-6ARB563V; Mouser Part Number 667-ERA-6ARB563V
R8, R10, R24: 10k; Manufacturer_Part_Number AT0805FRD0710KL; Mouser Part Number 603-AT0805FRD0710KL
R18: 1k; Manufacturer_Part_Number RC0805FR-071KL; Mouser Part Number 603-RC0805FR-071KL
R19: 100; Manufacturer_Part_Number AA0805FR-13100RL; Mouser Part Number 603-AA0805FR-13100RL

Connections:
+12V_LOGIC: C6.2, C7.2, C8.2, C13.2, IC2.14 (VDD), IC3.14 (VDD), IC5.14 (VDD), R6.1, R10.1
+12V_SHDW: R18.1, R24.1
CHARGE_REQUIRED_IN: IC3.3 (B), R10.2
CMD_AIR_NEG_OUT: IC2.3 (J=A.B), IC2.5 (C), IC2.8 (E)
CMD_AIR_POS_OUT: IC2.4 (K=C.D), IC3.9 (D), IC5.1 (A)
CMD_AIR_PRE_OUT: IC2.10 (L=E.F)
ENABLE_IN: Q4.1 (G), R8.2
GND: C7.1, C8.1, C13.1, IC2.7 (VSS), IC2.12 (G), IC2.13 (H), IC3.5 (C), IC3.7 (VSS), IC3.11 (E), IC3.13 (F), IC5.5 (C), IC5.6 (D), IC5.7 (VSS), IC5.8 (E), IC5.9 (F), IC5.12 (G), IC5.13 (H), Q4.2 (S), R8.1, R24.2
unnamed: C6.1, IC3.1 (A), R6.2, R19.2
unnamed: IC2.1 (A), R18.2
unnamed: IC2.2 (B), IC3.2 (~A)
unnamed: IC2.6 (D), IC5.3 (J=A+B)
unnamed: IC2.9 (F), IC3.8 (~D)
unnamed: IC3.4 (~B), IC5.2 (B)
unnamed: Q4.3 (D), R19.1

Notes on the sheet:
Enable 50ms timer
Input: V_{ENABLE_IN} = 5V to 24V Output: V_{ENABLE_delayed} = 0V / 12V (50ms falling-edge delay) Sizing ENABLE Level Shifter: Q4 = 2N7002K (V_{GS(th)} = 1V to 2.5V < V_{ENABLE_min} = 5V, max V_{DS} = 60V > 12V) R10 = 10kOhm pull-up to 12V (I_{R10_max} = 12V / 10kOhm = 1.2mA) R11 = 100kOhm gate pull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
Local decoupling for IC2, IC3, IC5
Logic
Input: V_{ENABLE_delayed} = 0V / 12V, V_{CHARGE_REQUIRED_IN} = 0V / 12V, +12V_SHDW, +12V_LOGIC Output: V_{CMD_AIR_NEG}, V_{CMD_AIR_PRE}, V_{CMD_AIR_POS} = 0V / 12V Max current draw: I_{IC2} + I_{IC3} + I_{IC5} = 5uA + 5uA + 5uA = 15uA (< 1mA) Sizing Logic Gates & Input Protection: IC2 = CD4081B (Qu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
