berta00/precharge-controller/hardware/lv_power_supply.kicad_sch

## KiCad design hardware/lv_power_supply.kicad_sch (2026-11-01)

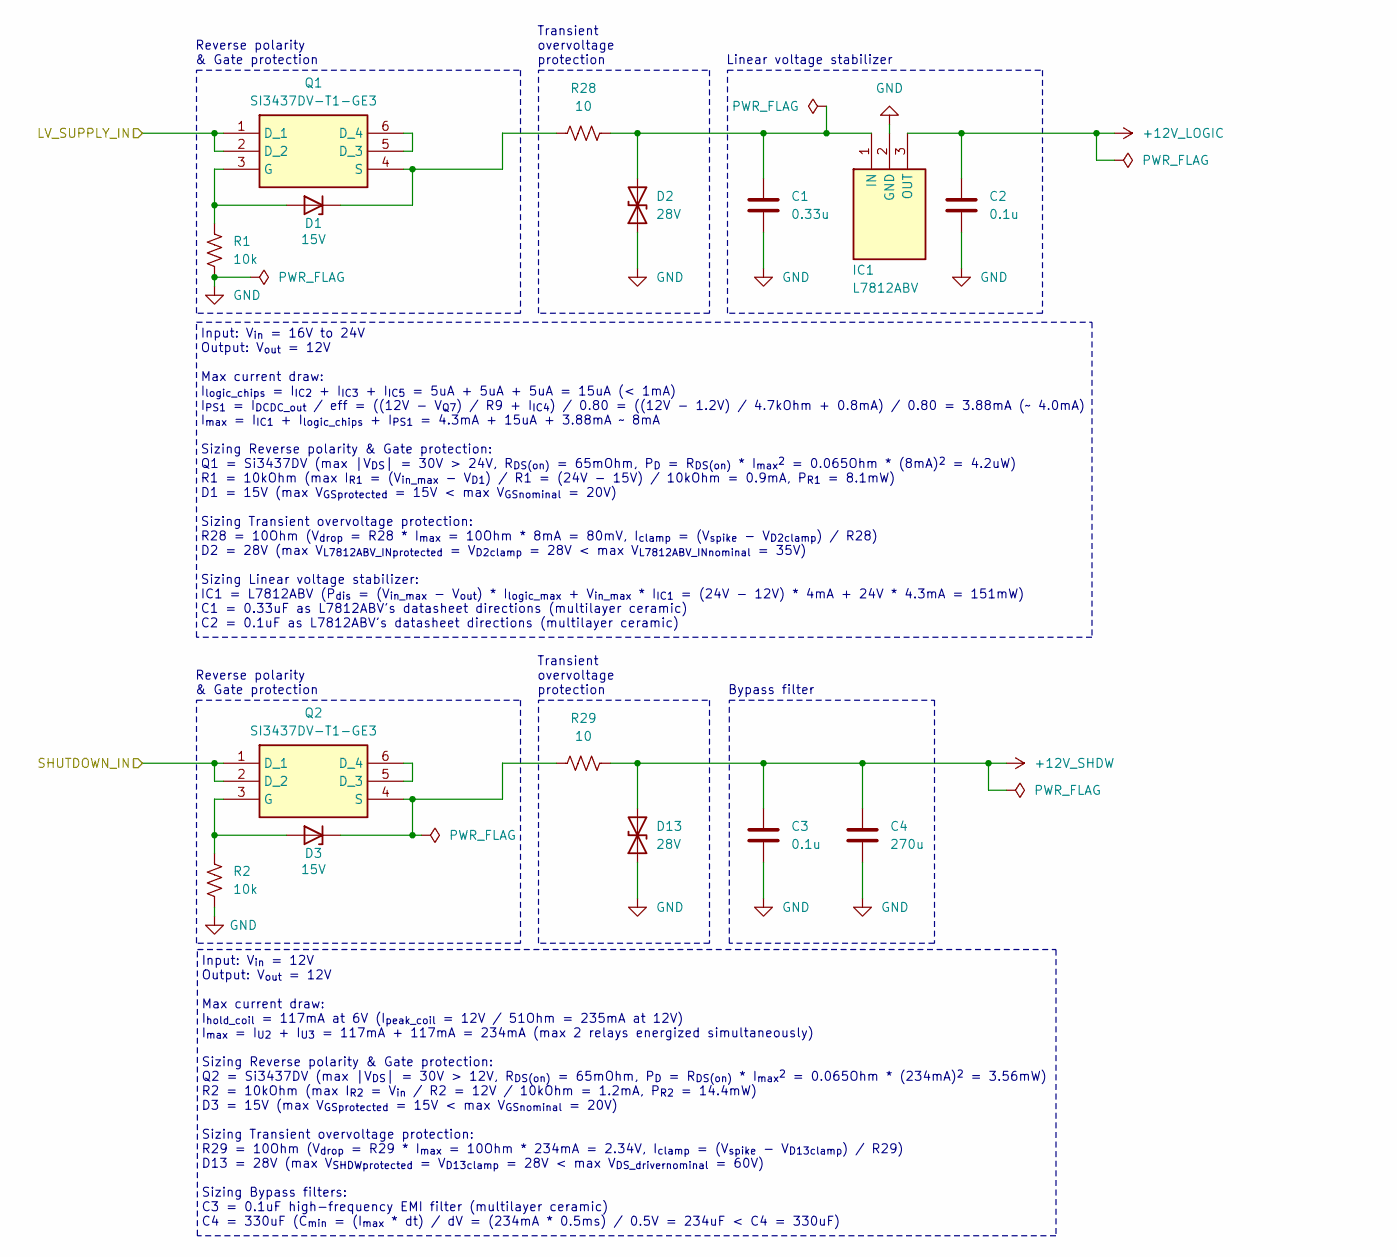
[picture p30: schematic lv_power_supply.kicad_sch]

Parts:
C1: 0.33u; C0805; Manufacturer_Part_Number C0805C334J5RACAUTO; Mouser Part Number 80-C0805C334J5RAUTO
C2, C3: 0.1u; C0805; Manufacturer_Part_Number C0805X104K5RACAUTO; Mouser Part Number 80-C0805X104K5RAUTO
C4: 270u; CAPPRD500W65D1025H1100; Manufacturer_Part_Number 35CZH270M10X9; Mouser Part Number 232-35CZH270M10X9
D1, D3: 15V; SOD3716X135N; Manufacturer_Part_Number MMSZ5245BHE3-TP; Mouser Part Number 833-MMSZ5245BHE3-TP
D2, D13: 28V; SOD3716X145N; Manufacturer_Part_Number MMSZ5255BQ-7-F; Mouser Part Number 621-MMSZ5255BQ-7-F
IC1: L7812ABV; TO255P460X1020X2008-3P; Manufacturer_Part_Number L7812ABV; Mouser Part Number 511-L7812ABV
Q1, Q2: SI3437DV-T1-GE3; SOT95P284X110-6N; Manufacturer_Part_Number SI3437DV-T1-GE3; Mouser Part Number 781-SI3437DV-GE3
R1, R2: 10k; Manufacturer_Part_Number AT0805FRD0710KL; Mouser Part Number 603-AT0805FRD0710KL
R28, R29: 10; Manufacturer_Part_Number SR0805FR-7W10RL; Mouser Part Number 603-SR0805FR-7W10RL

Connections:
+12V_LOGIC: C2.1, IC1.3 (OUT)
+12V_SHDW: C3.1, C4.1, D13.2 (A2), R29.2
GND: C1.2, C2.2, C3.2, C4.2, D2.1 (A1), D13.1 (A1), IC1.2 (GND), R1.2, R2.2
LV_SUPPLY_IN: Q1.1 (D_1), Q1.2 (D_2)
unnamed: C1.1, D2.2 (A2), IC1.1 (IN), R28.2
unnamed: D1.1 (K), Q1.4 (S), R28.1
unnamed: D1.2 (A), Q1.3 (G), R1.1
unnamed: D3.1 (K), Q2.4 (S), R29.1
unnamed: D3.2 (A), Q2.3 (G), R2.1
unnamed: Q1.5 (D_3), Q1.6 (D_4)
unnamed: Q2.5 (D_3), Q2.6 (D_4)
SHUTDOWN_IN: Q2.1 (D_1), Q2.2 (D_2)

Notes on the sheet:
Reverse polarity & Gate protection
Input: V_{in} = 16V to 24V Output: V_{out} = 12V Max current draw: I_{logic_chips} = I_{IC2} + I_{IC3} + I_{IC5} = 5uA + 5uA + 5uA = 15uA (< 1mA) I_{PS1} = I_{DCDC_out} / eff = ((12V - V_{Q7}) / R9 + I_{IC4}) / 0.80 = ((12V - 1.2V) / 4.7kOhm + 0.8mA) / 0.80 = 3.88mA (~ 4.0mA) I_{max} = I_{IC1} + I_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
Transient overvoltage protection
Input: V_{in} = 12V Output: V_{out} = 12V Max current draw: I_{hold_coil} = 117mA at 6V (I_{peak_coil} = 12V / 51Ohm = 235mA at 12V) I_{max} = I_{U2} + I_{U3} = 117mA + 117mA = 234mA (max 2 relays energized simultaneously) Sizing Reverse polarity & Gate protection: Q2 = Si3437DV (max |V_{DS}| = 30V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
Linear voltage stabilizer
Bypass filter
