berta00/precharge-controller/hardware/lv_relay_drive.kicad_sch

## KiCad design hardware/lv_relay_drive.kicad_sch (2026-11-01)

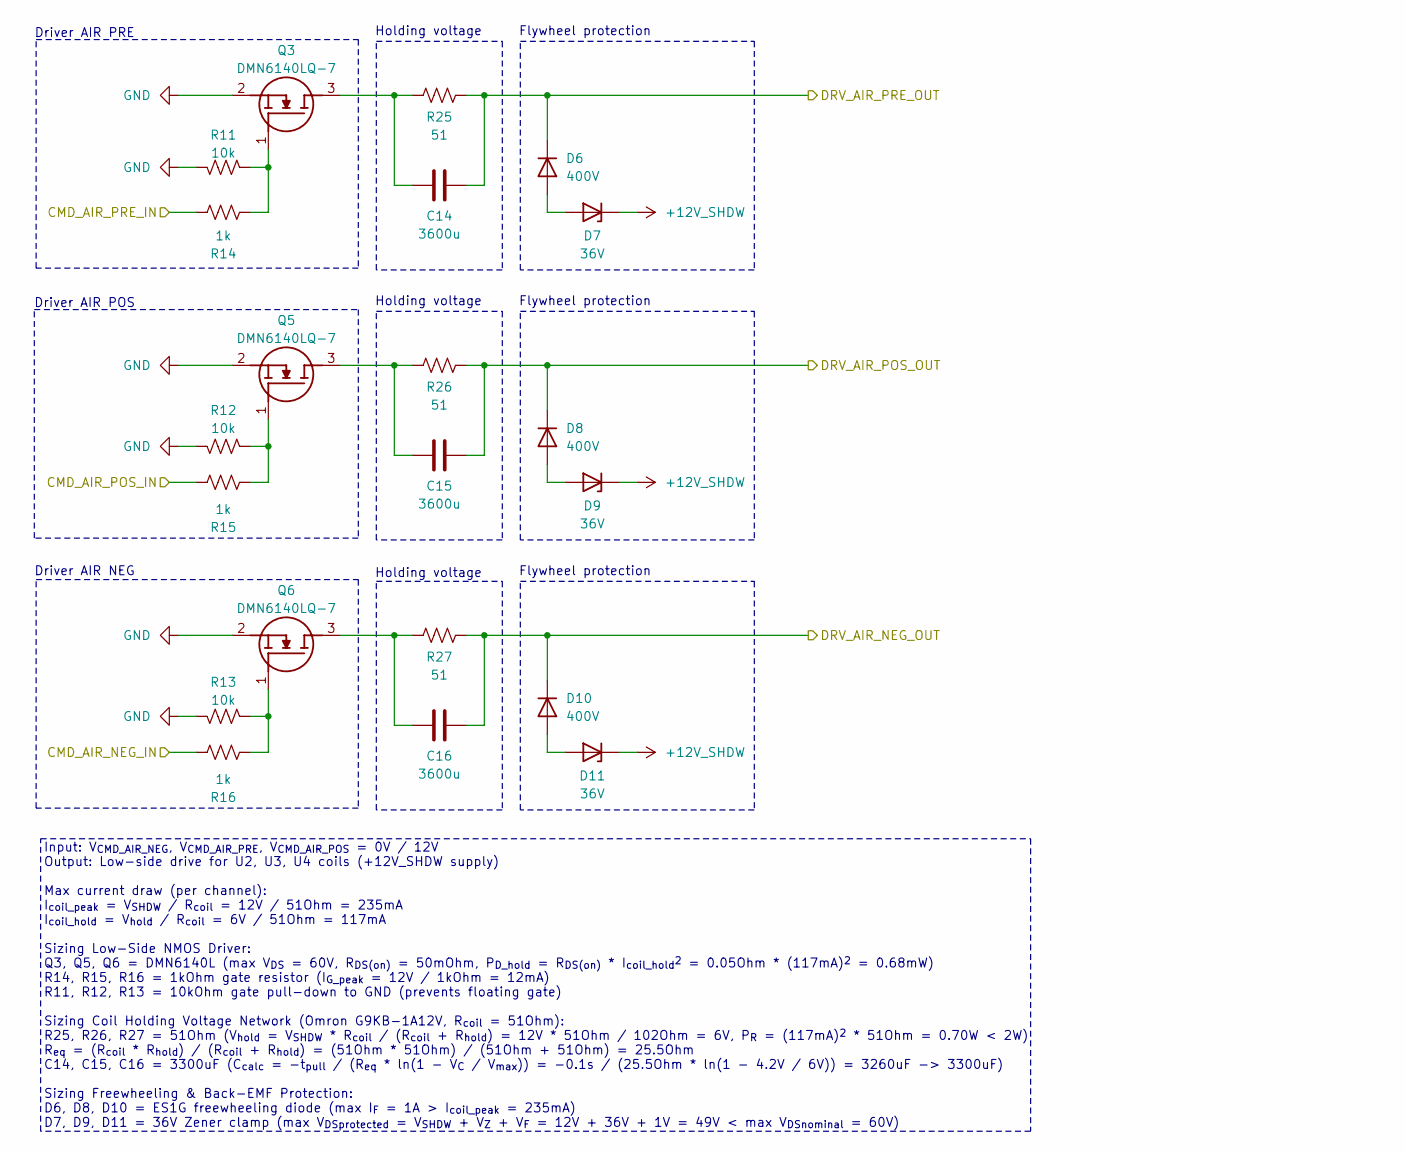
[picture p31: schematic lv_relay_drive.kicad_sch]

Parts:
C14, C15, C16: 3600u; Manufacturer_Part_Number PHH223HKP4360ME4; Mouser Part Number 80-PHH223HKP4360ME4
D6, D8, D10: 400V; Manufacturer_Part_Number S1G; Mouser Part Number 603-S1G
D7, D9, D11: 36V; Manufacturer_Part_Number 1SMA5938BT3G; Mouser Part Number 863-1SMA5938BT3G
Q3, Q5, Q6: DMN6140LQ-7; SOT96P240X110-3N; Manufacturer_Part_Number DMN6140LQ-7; Mouser Part Number 621-DMN6140LQ-7
R11, R12, R13: 10k; Manufacturer_Part_Number AT0805FRD0710KL; Mouser Part Number 603-AT0805FRD0710KL
R14, R15, R16: 1k; Manufacturer_Part_Number RC0805FR-071KL; Mouser Part Number 603-RC0805FR-071KL
R25, R26, R27: 51; Manufacturer_Part_Number RSF2WSJR-52-51R; Mouser Part Number 603-RSF2WSJR-52-51R

Connections:
+12V_SHDW: D7.1 (K), D9.1 (K), D11.1 (K)
CMD_AIR_NEG_IN: R16.2
CMD_AIR_POS_IN: R15.2
CMD_AIR_PRE_IN: R14.2
DRV_AIR_NEG_OUT: C16.1, D10.1 (K), R27.2
DRV_AIR_POS_OUT: C15.1, D8.1 (K), R26.2
DRV_AIR_PRE_OUT: C14.1, D6.1 (K), R25.2
GND: Q3.2 (S), Q5.2 (S), Q6.2 (S), R11.2, R12.2, R13.2
unnamed: C14.2, Q3.3 (D), R25.1
unnamed: C15.2, Q5.3 (D), R26.1
unnamed: C16.2, Q6.3 (D), R27.1
unnamed: D6.2 (A), D7.2 (A)
unnamed: D8.2 (A), D9.2 (A)
unnamed: D10.2 (A), D11.2 (A)
unnamed: Q3.1 (G), R11.1, R14.1
unnamed: Q5.1 (G), R12.1, R15.1
unnamed: Q6.1 (G), R13.1, R16.1

Notes on the sheet:
Holding voltage
Flywheel protection
Driver AIR POS
Driver AIR PRE
Input: V_{CMD_AIR_NEG}, V_{CMD_AIR_PRE}, V_{CMD_AIR_POS} = 0V / 12V Output: Low-side drive for U2, U3, U4 coils (+12V_SHDW supply) Max current draw (per channel): I_{coil_peak} = V_{SHDW} / R_{coil} = 12V / 51Ohm = 235mA I_{coil_hold} = V_{hold} / R_{coil} = 6V / 51Ohm = 117mA Sizing Low-Side NMOS 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
Driver AIR NEG
