berta00/precharge-controller/hardware/lv_rele_drive.kicad_sch

## KiCad design hardware/lv_rele_drive.kicad_sch (2026-10-23)

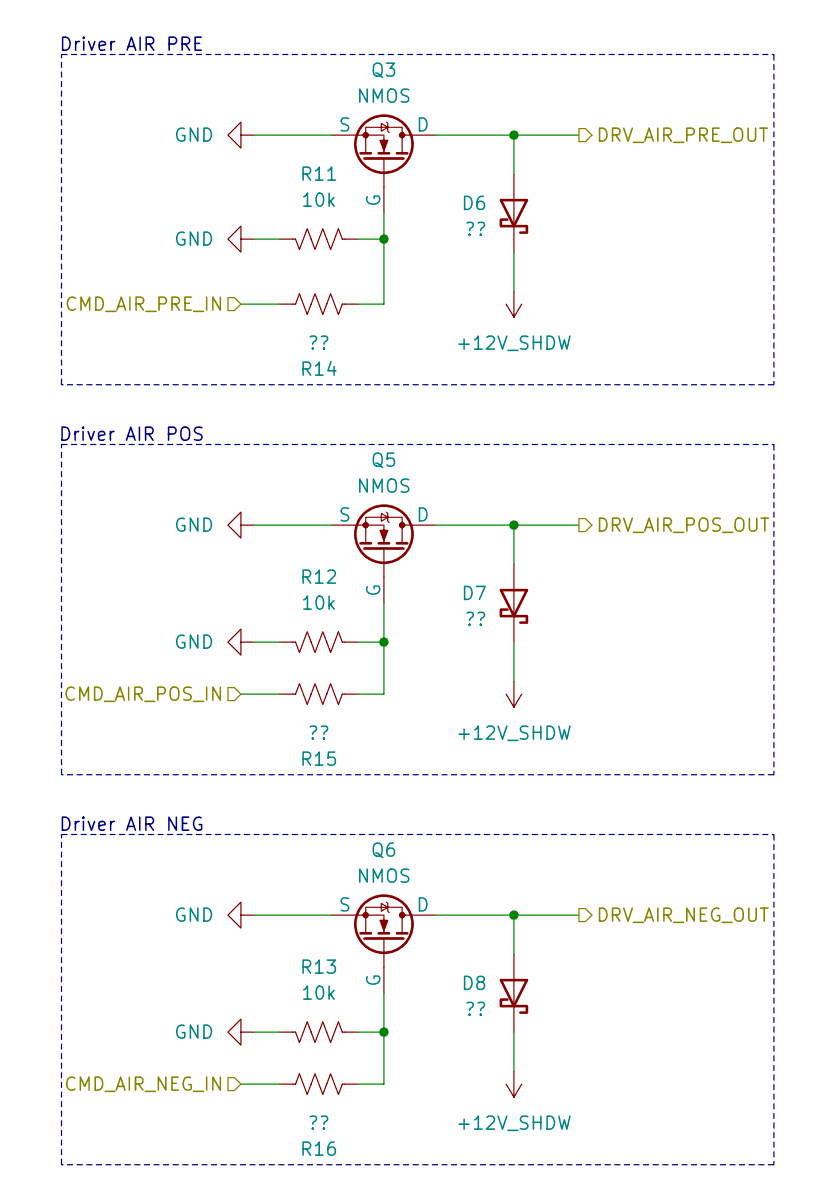
[picture p32: schematic lv_rele_drive.kicad_sch]

Parts:
D6, D7, D8: ??
Q3, Q5, Q6: NMOS
R11, R12, R13: 10k
R14, R15, R16: ??

Connections:
+12V_SHDW: D6.1 (K), D7.1 (K), D8.1 (K)
CMD_AIR_NEG_IN: R16.2
CMD_AIR_POS_IN: R15.2
CMD_AIR_PRE_IN: R14.2
DRV_AIR_NEG_OUT: D8.2 (A), Q6.1 (D)
DRV_AIR_POS_OUT: D7.2 (A), Q5.1 (D)
DRV_AIR_PRE_OUT: D6.2 (A), Q3.1 (D)
GND: Q3.3 (S), Q5.3 (S), Q6.3 (S), R11.2, R12.2, R13.2
unnamed: Q3.2 (G), R11.1, R14.1
unnamed: Q5.2 (G), R12.1, R15.1
unnamed: Q6.2 (G), R13.1, R16.1

Notes on the sheet:
Driver AIR POS
Driver AIR PRE
Driver AIR NEG
