berta00/precharge-controller/hardware/power_supply.kicad_sch

## KiCad design hardware/power_supply.kicad_sch (2026-10-20)

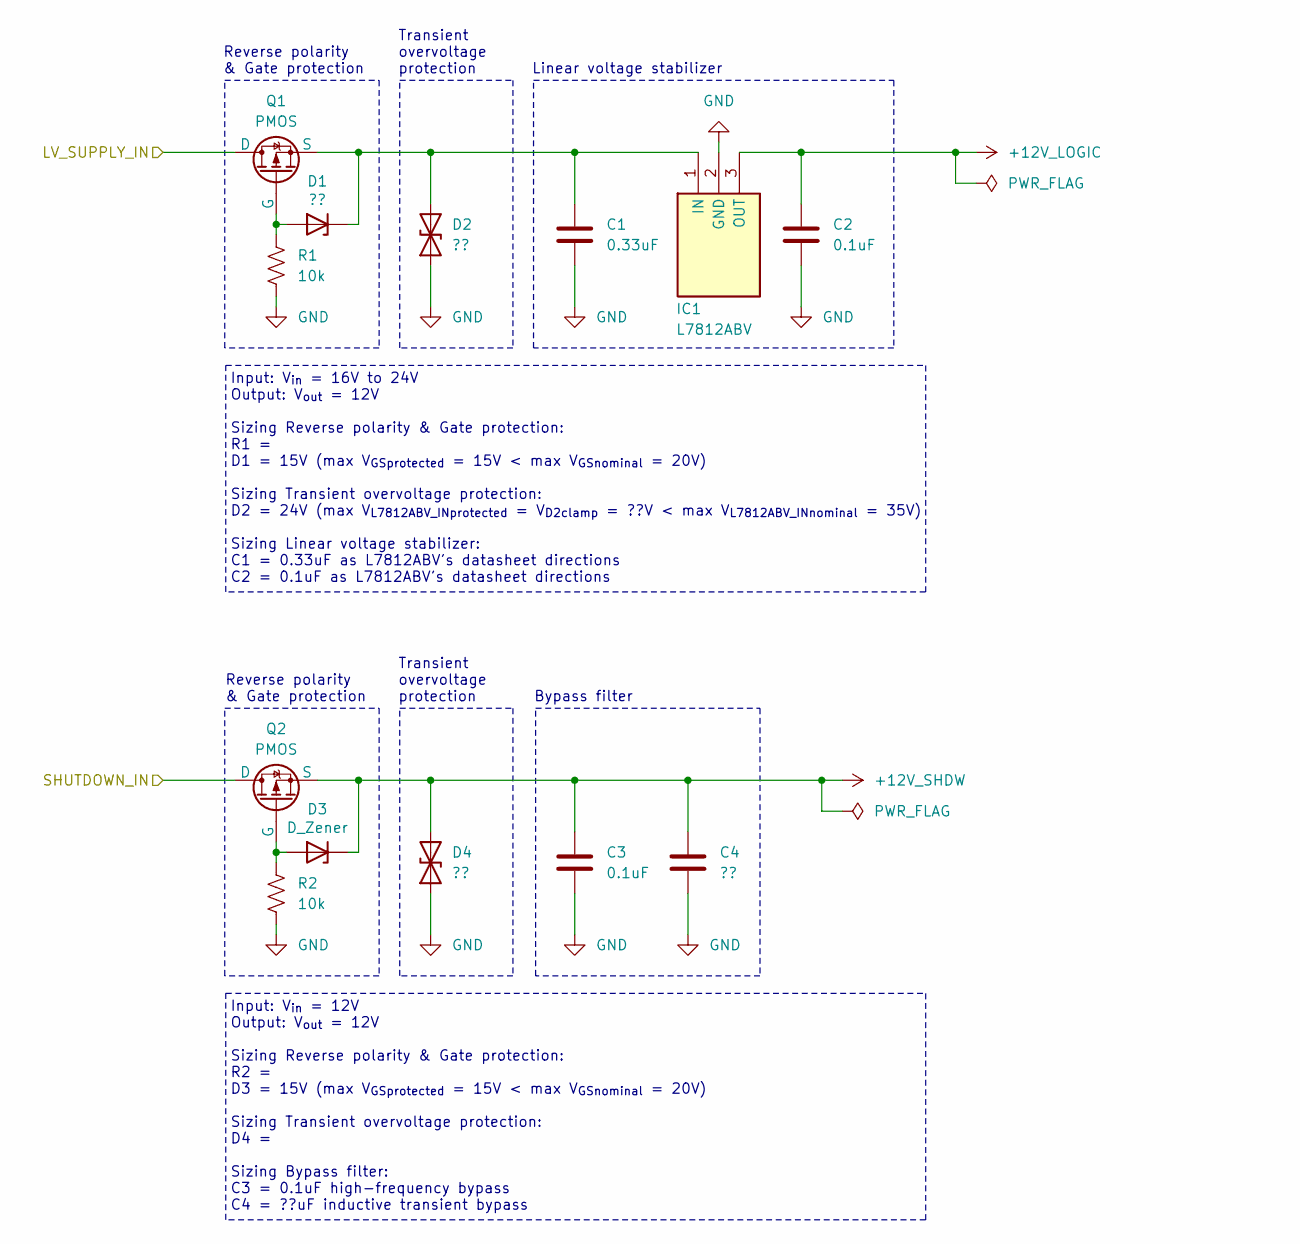
[picture p33: schematic power_supply.kicad_sch]

Parts:
C1: 0.33uF
C2, C3: 0.1uF
C4: ??
D1, D2, D4: ??
D3: D_Zener
IC1: L7812ABV; TO255P460X1020X2008-3P; Manufacturer_Part_Number L7812ABV; Mouser Part Number 511-L7812ABV
Q1, Q2: PMOS
R1, R2: 10k

Connections:
+12V_LOGIC: C2.1, IC1.3 (OUT)
+12V_SHDW: C3.1, C4.1, D3.1 (K), D4.2 (A2), Q2.3 (S)
GND: C1.2, C2.2, C3.2, C4.2, D2.1 (A1), D4.1 (A1), IC1.2 (GND), R1.2, R2.2
LV_SUPPLY_IN: Q1.1 (D)
unnamed: C1.1, D1.1 (K), D2.2 (A2), IC1.1 (IN), Q1.3 (S)
unnamed: D1.2 (A), Q1.2 (G), R1.1
unnamed: D3.2 (A), Q2.2 (G), R2.1
SHUTDOWN_IN: Q2.1 (D)

Notes on the sheet:
Reverse polarity & Gate protection
Input: V_{in} = 16V to 24V Output: V_{out} = 12V Sizing Reverse polarity & Gate protection: R1 = D1 = 15V (max V_{GS}_{protected} = 15V < max V_{GS}_{nominal} = 20V) Sizing Transient overvoltage protection: D2 = 24V (max V_{L7812ABV_IN}_{protected} = V_{D2}_{clamp} = ??V < max V_{L7812ABV_IN}_{nomi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
Transient overvoltage protection
Input: V_{in} = 12V Output: V_{out} = 12V Sizing Reverse polarity & Gate protection: R2 = D3 = 15V (max V_{GS}_{protected} = 15V < max V_{GS}_{nominal} = 20V) Sizing Transient overvoltage protection: D4 = Sizing Bypass filter: C3 = 0.1uF high-frequency bypass C4 = ??uF inductive transient bypass
Linear voltage stabilizer
Bypass filter
