berta00/precharge-controller/hardware/precharge-controller.kicad_sch

## KiCad design hardware/precharge-controller.kicad_sch (2026-11-01)

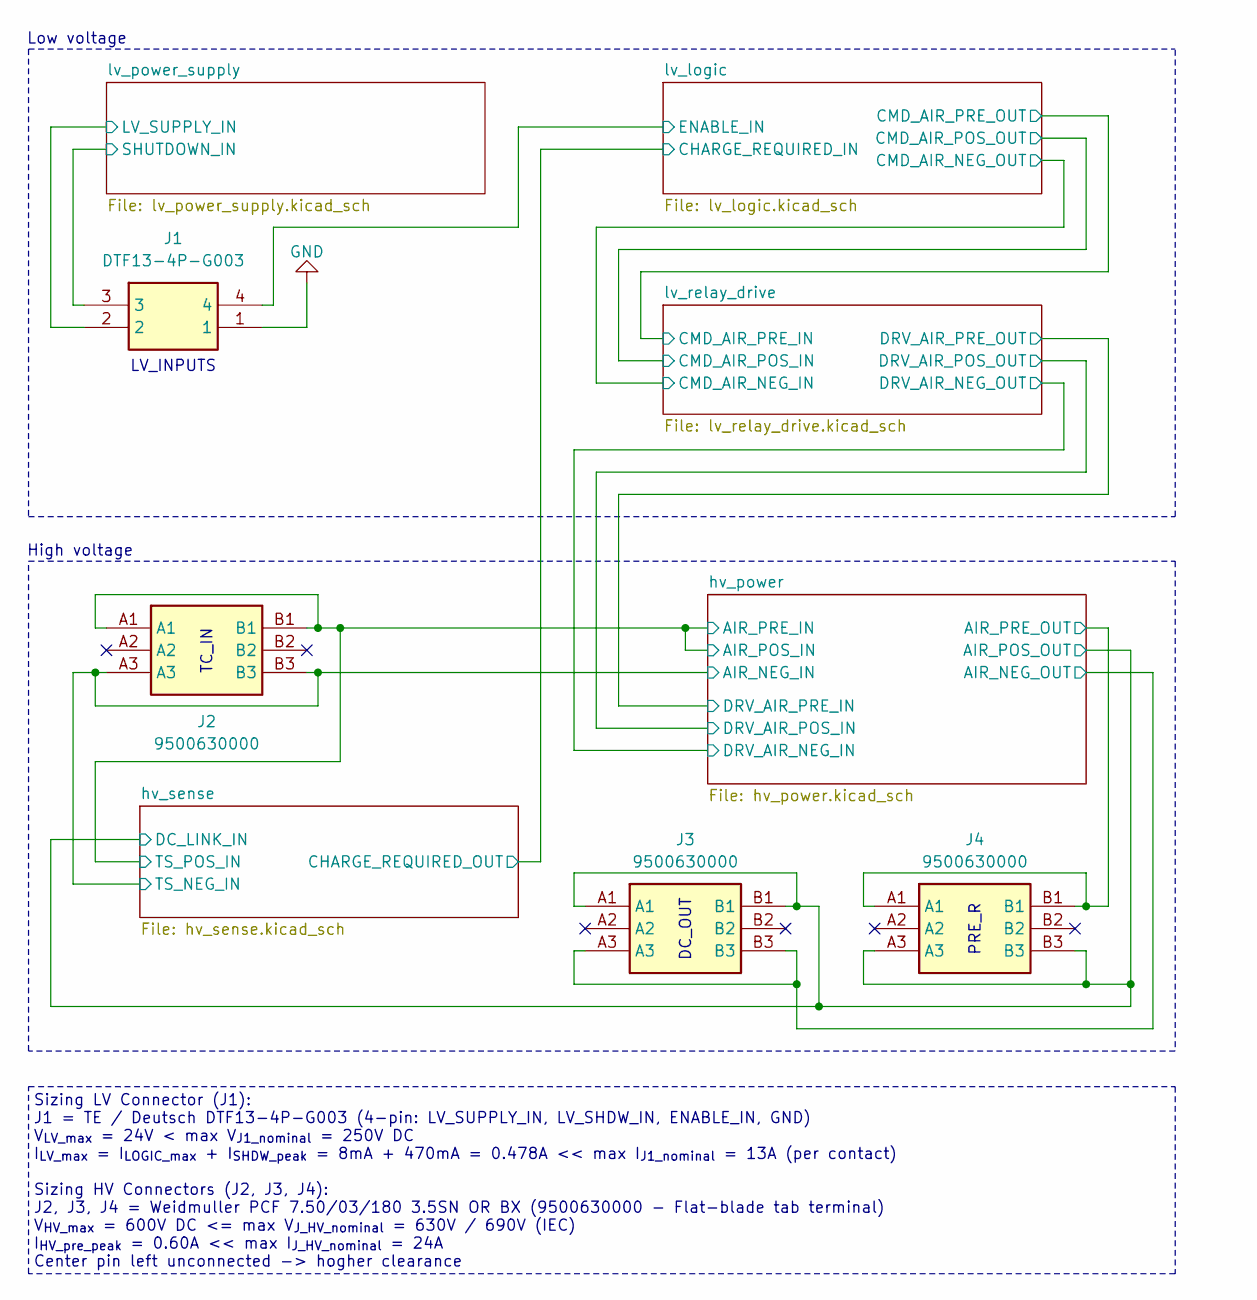
[picture p34: schematic precharge-controller.kicad_sch]

Parts:
J1: DTF13-4P-G003; DTF134PG003; Manufacturer_Part_Number DTF13-4P-G003; Mouser Part Number 571-DTF13-4P-G003
J2, J3, J4: 9500630000; Manufacturer_Part_Number 9500630000; Mouser Part Number 470-9500630000

Connections:
AIR_NEG_IN: J2.A3, J2.B3
AIR_NEG_OUT: J3.A3, J3.B3
AIR_POS_IN: J2.A1, J2.B1
AIR_POS_OUT: J3.A1, J3.B1, J4.A3, J4.B3
AIR_PRE_OUT: J4.A1, J4.B1
ENABLE_IN: J1.4
GND: J1.1
LV_SUPPLY_IN: J1.2
SHUTDOWN_IN: J1.3

Notes on the sheet:
Low voltage
TC_IN
PRE_R
High voltage
DC_OUT
LV_INPUTS
Sizing LV Connector (J1): J1 = TE / Deutsch DTF13-4P-G003 (4-pin: LV_SUPPLY_IN, LV_SHDW_IN, ENABLE_IN, GND) V_{LV_max} = 24V < max V_{J1_nominal} = 250V DC I_{LV_max} = I_{LOGIC_max} + I_{SHDW_peak} = 8mA + 470mA = 0.478A << max I_{J1_nominal} = 13A (per contact) Sizing HV Connectors (J2, J3, J4): 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
