berta00/precharge-controller/(commit log)

2026-10-19 add reverse polarity protection and stabilization to low input in power supply block
2026-10-20 create datasheet directory; create description file; rename kicad directory; add protection and filtering circuit to shutdown input in power supply block; add sizing description in power supply block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
2026-10-21 add datasheet for logic gates and high voltage connector
2026-10-21 add libs for logic gates and high voltage connector
2026-10-21 add relative libs to kicad
2026-10-21 complete hierarchial sheet organization; start hv_sense schematic; start lv_logic schematic; refactor hierarchial sheets
2026-10-22 add enable timer in logic block
2026-10-22 add enable timer sizing in logic block
2026-10-22 add enable timer simulation
2026-10-23 add traction system positive input to hv sense block with new dedicated connector
2026-10-24 refactor project layout merging high and low voltage in the same pcb
2026-10-24 import relay package; add relays and precharge resistor to hv_power block; add flywheel protections to lv_relay_drive block
2026-10-25 fix ERC power line errors
2026-10-25 refactor schematic and datasheet names
2026-10-25 add holding voltage to lv_relay_drive block
2026-10-30 add architecture overview, power supply / current budge, and low voltage logic's enable level shifter and timer sections
2026-10-30 add file structure and enable level shifter / timer sections
2026-10-30 add enable timer simulation, without proper component sizing
2026-10-30 start power supply and logic sizing
2026-10-31 done power supply sizing
2026-10-31 add relay drive NMOS lib and documentation
2026-10-31 done connectors sizing
2026-10-31 add external precharge resistor connector; finish connector sizing and labeling
2026-10-31 minor fix in SIZING.md; done Low voltage section in DESCRIPTION.md; done table of contents in DESCRIPTION.md; upload architecture block image;
2026-11-01 choose capacitors, diodes, and resistors model
2026-11-01 done BOM file
2026-11-01 final project trace
